DanielKirchner/bachelorarbeit/README.md

# Entwicklung einer hardwarebasierten Berechnung der Mandelbrotmenge auf einem FPGA

Dieses Repoistory enthält alle selbsterstellten Ressourcen zur gleichnamigen Bachelorarbeit.
Folgende Dateien sind enthalten:

| Pfad | Beschreibung |
| --- | --- |
|`/arbeit/`|Latex-Quelldateien der Bachelorarbeit. Ordner `/arbeit/img/` enthält alle in der Arbeit verwendeten Bilder.|
|`/präsentation/`|Latex-Quelldateien der Präsentation im Rahmen des Bachelorseminars. Ordner `/präsentation/img/` enthält alle in der Arbeit verwendeten Bilder.|
|`/scripts/`|Enthält Python3 Skripts die zur Erstellung von Darstellungen verwendet wurden.|
|`/scripts/divergenz.py`|Interaktives Skript zur Darstellung der Divergenz/Konvergenz von auswählbaren komplexzahligen Punkten.|
|`/scripts/mandelbrot-single-point.py`|Skript zur Ausgabe der Punkte `z`, die für ein bestimmtes `c` iteriert werden.|
|`/scripts/tree.py`|Turtle-Skript zum Darstellen eines fraktalen Baums. Modifizierter Code von [stackoverflow](https://stackoverflow.com/questions/39853005/drawing-a-fractal-tree-in-python-not-sure-how-to-proceed).|
|`/scripts/utils.py`|Skript mit verschiedenen Utility-Funktionen, die im Rahmen des Projekts nützlich waren.|
|`/src/`|Vivado VHDL-Projekt des entwickelten FPGA-Systems.|
|`/waveforms/`|WaveDrom Quelldateien zur Erstellung der in der Arbeit dargestellten  Wellenformen.|
