DanielKirchner/bachelorarbeit/präsentation/präsentation.pdf

D. Kirchner, Mandelbrotmenge in Hardware

## Entwicklung einer hardwarebeschleunigten Berechnung der Mandelbrotmenge auf einem FPGA

Daniel Kirchner

betreut durch: Prof. Oliver Engel Hochschule Coburg

21.05.2019

## Ubersicht ¨

Die Mandelbrotmenge

Umsetzung in Hardware

Optimierungen

Die Mandelbrotmenge

## Die Mandelbrotmenge

I nach Benoˆıt Mandelbrot, Begr¨under des Begriffs ”Fraktal” I lat. fractus: gebrochen
I selbst¨ahnliche Strukturen in Natur und Mathematik

## Fraktale in der Natur

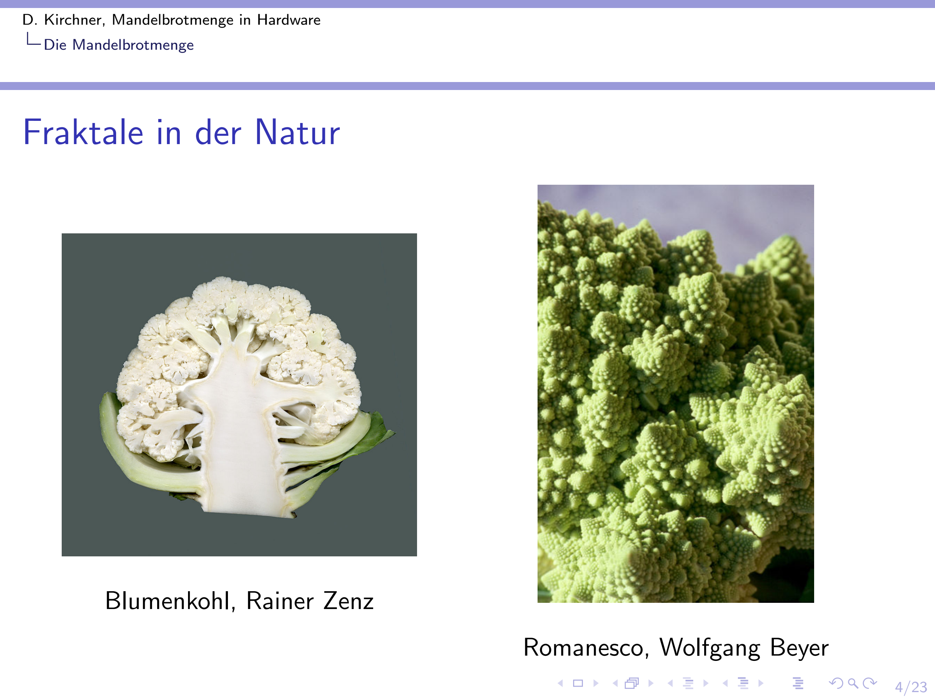
[picture p32: page 4]

Die Mandelbrotmenge

Blumenkohl, Rainer Zenz

Romanesco, Wolfgang Beyer

Die Mandelbrotmenge

Demonstration: Fraktaler Baum

Die Mandelbrotmenge

## Definition

Definiert durch iterative Formel:

z0 = 0

zn+1 = z

2
n + c

Zur Menge geh¨oren diejenigen c, f¨ur die die Folge beschr¨ankt ist.

Die Mandelbrotmenge

Demonstration: Konvergenz/Divergenz verschiedener c

Die Mandelbrotmenge

## Darstellung

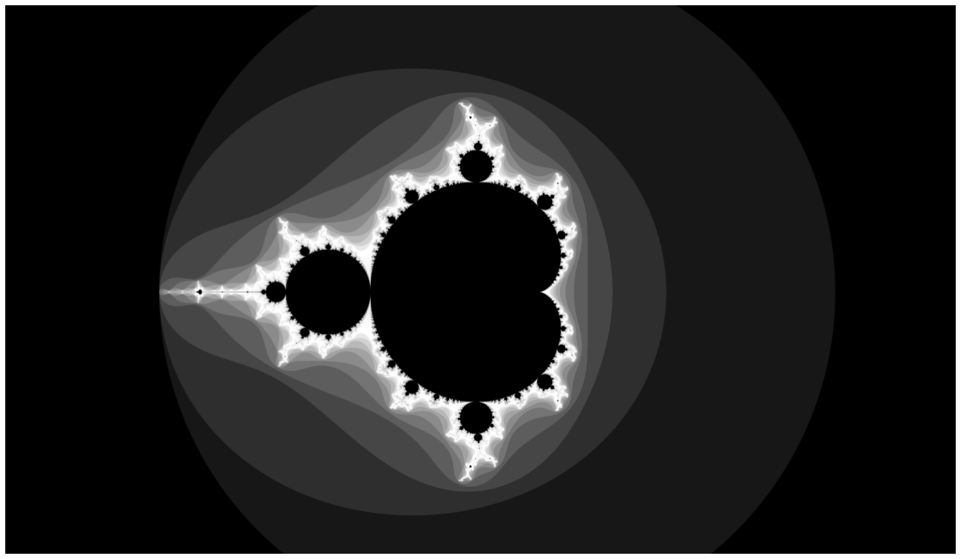
[picture p33: figure]

Umsetzung in Hardware

## Umsetzung in Hardware

I Problem: Visualisierung der Mandelbrotmenge enorm rechenintensiv
I L¨osung: Jedoch leicht parallelisierbar, ideal f¨ur Hardwareeinsatz

Umsetzung in Hardware

## Gegebene Hardware

Zybo FPGA Trainer Board
I 28.000 Logikzellen
I 240 KB Block RAM
I 80 DSPs
I Dual-Core ARM
processor
I VGA Output

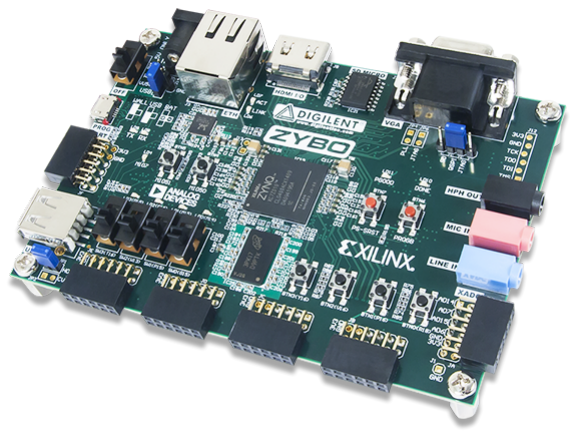
[picture p34: figure]

Zybo Board, Digilent

Umsetzung in Hardware

## Komponenten


Umsetzung in Hardware

## Mandelbrot Core

I Berechnet f¨ur gegebenes c die Anzahl an ben¨otigten Iterationen
I Ziel: eine Iteration pro Takt

Umsetzung in Hardware

## Koordinator

I Ubersetzt Pixelkoordinaten in einzelne ¨ | c Werte

I Koordiniert die Inputs der einzelnen Kerne
I Schreibt Ergebniswerte (Iterationen) in den BRAM

Umsetzung in Hardware

## VGA Modul / Block RAM

I Werte im RAM Stellen Iterationsbereich da I 240 KB Block RAM verf¨ugbar
I 800x600 Signal mit 3 Bit pro Pixel
I 8 Farben pro Pixel
I Funktionsweise: Pixel f¨ur Pixel auslesen und darstellen

Umsetzung in Hardware

## VGA Modul

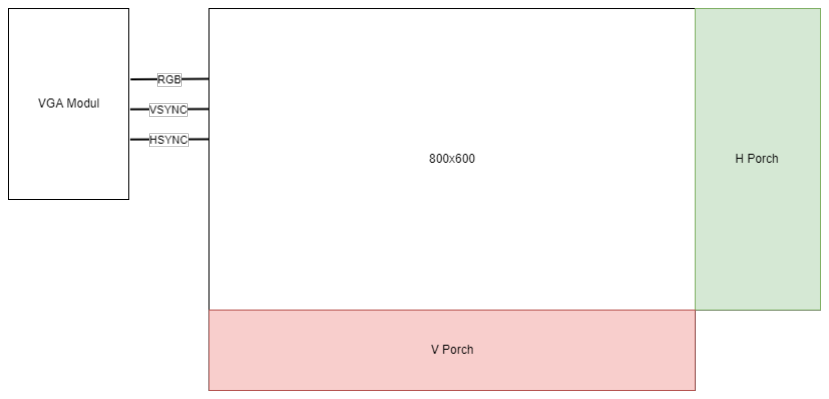
[picture p35: figure]

Umsetzung in Hardware

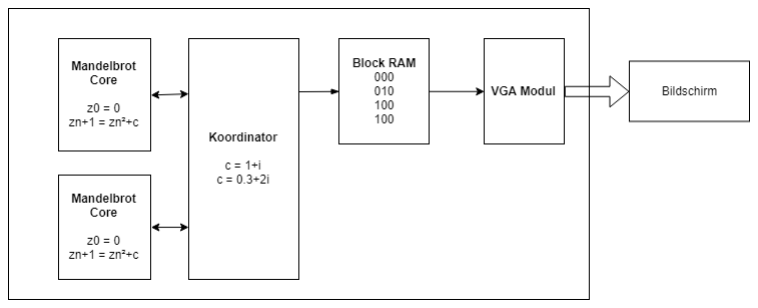
[picture p36: figure]

Optimierungen

## Algebraische Optimierungen

In jedem Schritt:
z = z

2 + c

und dann Abfrage:
abs(z) <= 2

Ziel: Minimale Zahl von Multiplikationen

Optimierungen

abs(z) <= 2

⇔

q
z

2
r + z

2
i <= 2

⇔ z

2
r + z

2
i <= 4

Optimierungen

z = z

2 + c

⇔ z = z

2
r − z

2
i + 2zr zi + c

zr = z

2
r − z

2
i + cr

zi = 2zr zi + ci

⇔ zi = zr zi + zr zi + ci

Optimierungen

z

2
r + z

2
i <= 4

zr = z

2
r − z

2
i + cr

zi = zr zi + zr zi + ci

Optimierungen

## Designtechnische Optimierungen

I VGA-Modul und Mandelbrotcores m¨ussen beide auf BRAM zugreifen → Dual Port RAM
I Mandelbrotmenge ist geschlossen: y zwischen -1.25 und 1.25, x zwischen -2 und 0,5 → Punkte außerhalb nicht in Menge I Eigener signed-Datenformat

Optimierungen

## Zahlenformat

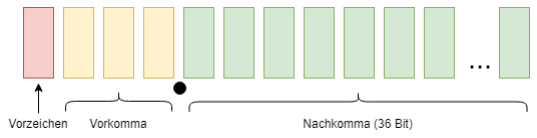
[picture p37: figure]
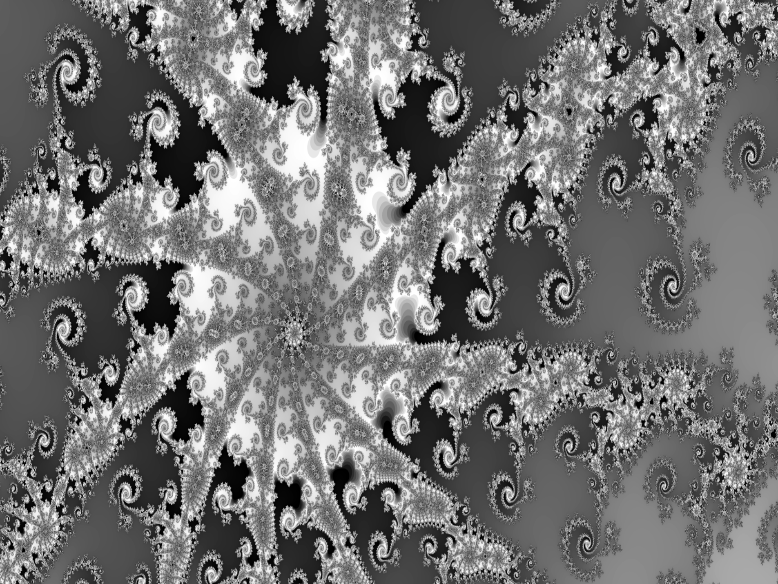
[picture p38: page 23]
