DanielKirchner/bachelorarbeit/arbeit/img/mandelbrot_1.png

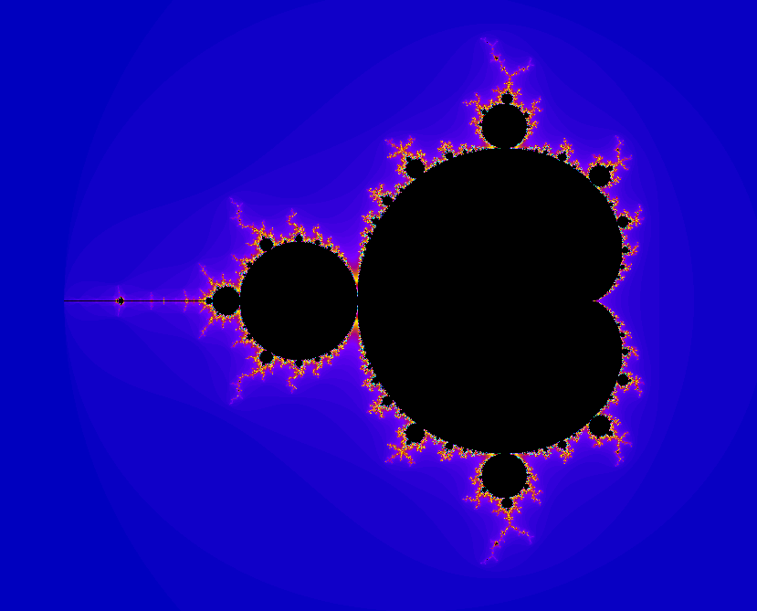
arbeit/img/mandelbrot_1.png
