DanielKirchner/bachelorarbeit/arbeit/img/mandelbrot_2.png

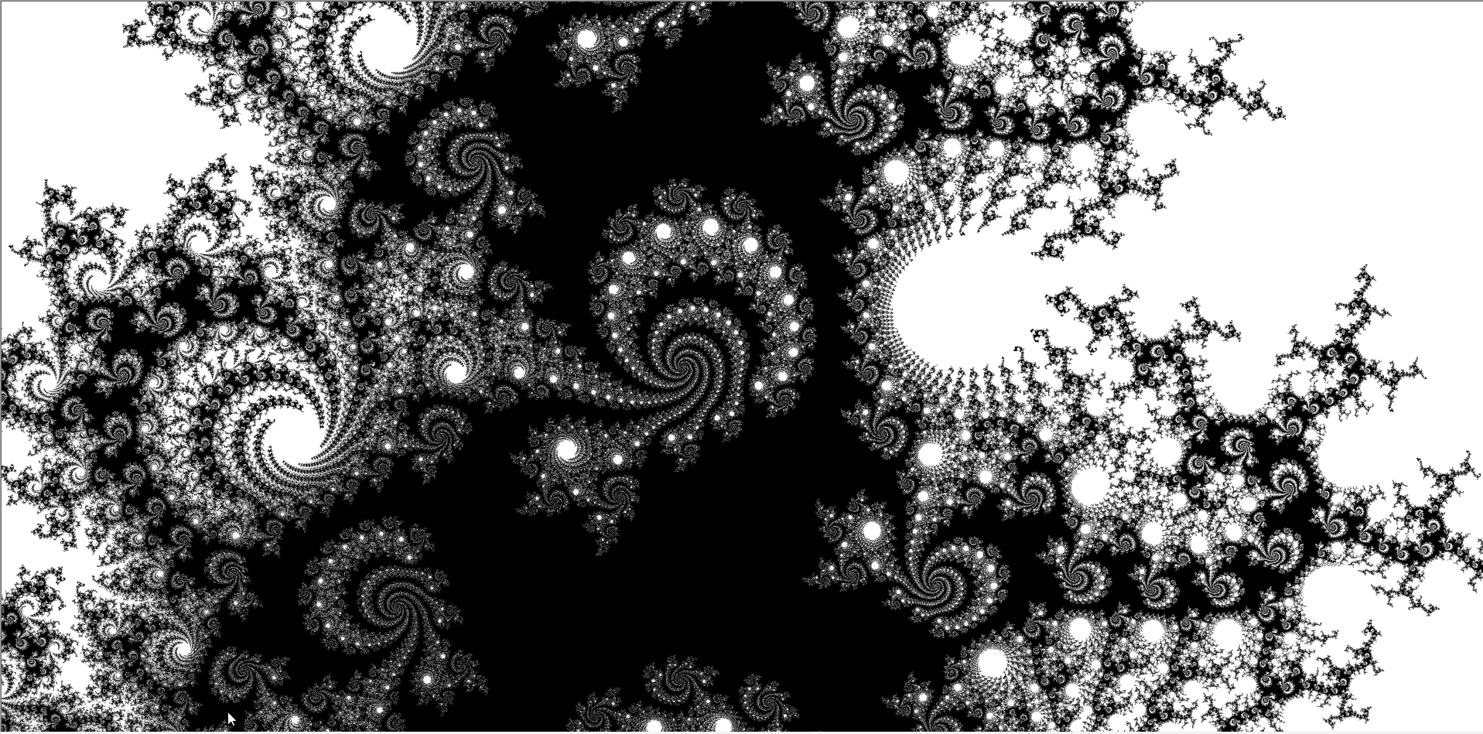
arbeit/img/mandelbrot_2.png
