DanielKirchner/bachelorarbeit/arbeit/img/realtop.png

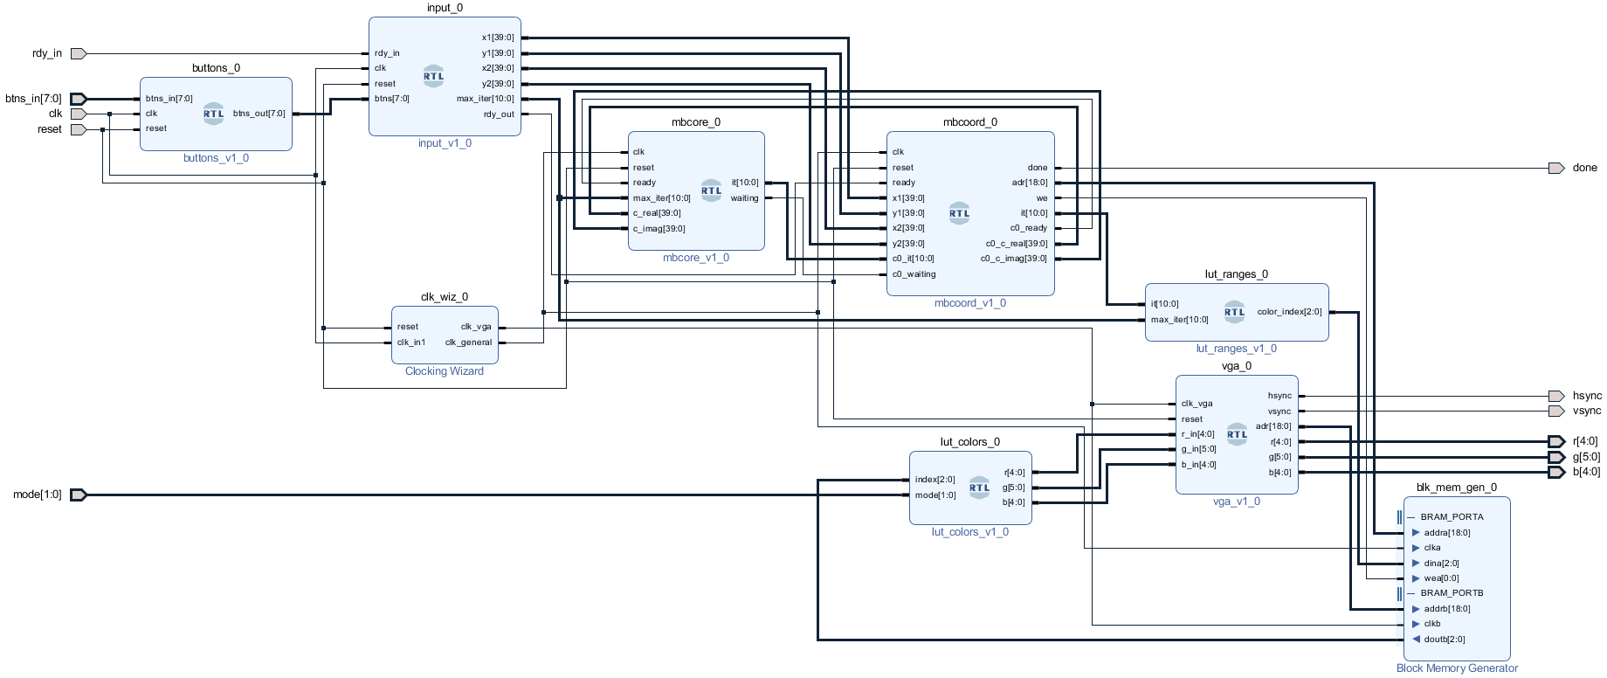
arbeit/img/realtop.png
