DanielKirchner/bachelorarbeit/src/mandel-zybo.srcs/sources_1/bd/top/ip/top_input_0_0/top_input_0_0_sim_netlist.v

// Copyright 1986-2018 Xilinx, Inc. All Rights Reserved.
// --------------------------------------------------------------------------------
// Tool Version: Vivado v.2018.3 (lin64) Build 2405991 Thu Dec  6 23:36:41 MST 2018
// Date        : Sun Jul 28 16:13:38 2019
// Host        : daniel-pc running 64-bit unknown
// Command     : write_verilog -force -mode funcsim
//               /home/daniel/prg/uni/bachelor/src/mandel-zybo.srcs/sources_1/bd/top/ip/top_input_0_0/top_input_0_0_sim_netlist.v
// Design      : top_input_0_0
// Purpose     : This verilog netlist is a functional simulation representation of the design and should not be modified
//               or synthesized. This netlist cannot be used for SDF annotated simulation.
// Device      : xc7z010clg400-1
// --------------------------------------------------------------------------------
`timescale 1 ps / 1 ps

(* CHECK_LICENSE_TYPE = "top_input_0_0,input,{}" *) (* downgradeipidentifiedwarnings = "yes" *) (* ip_definition_source = "module_ref" *) 
(* x_core_info = "input,Vivado 2018.3" *) 
(* NotValidForBitStream *)
module top_input_0_0
   (clk,
    reset,
    btns,
    x1,
    y1,
    x2,
    y2,
    max_iter,
    rdy_out);
  (* x_interface_info = "xilinx.com:signal:clock:1.0 clk CLK" *) (* x_interface_parameter = "XIL_INTERFACENAME clk, ASSOCIATED_RESET reset, FREQ_HZ 125000000, PHASE 0.000, CLK_DOMAIN top_clk, INSERT_VIP 0" *) input clk;
  (* x_interface_info = "xilinx.com:signal:reset:1.0 reset RST" *) (* x_interface_parameter = "XIL_INTERFACENAME reset, POLARITY ACTIVE_HIGH, INSERT_VIP 0" *) input reset;
  input [7:0]btns;
  output [39:0]x1;
  output [39:0]y1;
  output [39:0]x2;
  output [39:0]y2;
  output [13:0]max_iter;
  output rdy_out;

  wire \<const1> ;
  wire [7:0]btns;
  wire clk;
  wire [13:0]max_iter;
  wire reset;
  wire [39:0]x1;
  wire [39:0]x2;
  wire [39:0]y1;
  wire [39:0]y2;

  assign rdy_out = \<const1> ;
  top_input_0_0_input U0
       (.Q(y2),
        .btns(btns),
        .clk(clk),
        .max_iter(max_iter),
        .reset(reset),
        .\x1_intern_reg[39]_0 (x1),
        .\x2_intern_reg[39]_0 (x2),
        .\y1_intern_reg[39]_0 (y1));
  VCC VCC
       (.P(\<const1> ));
endmodule

(* ORIG_REF_NAME = "input" *) 
module top_input_0_0_input
   (Q,
    \y1_intern_reg[39]_0 ,
    \x2_intern_reg[39]_0 ,
    \x1_intern_reg[39]_0 ,
    max_iter,
    btns,
    clk,
    reset);
  output [39:0]Q;
  output [39:0]\y1_intern_reg[39]_0 ;
  output [39:0]\x2_intern_reg[39]_0 ;
  output [39:0]\x1_intern_reg[39]_0 ;
  output [13:0]max_iter;
  input [7:0]btns;
  input clk;
  input reset;

  wire [39:0]Q;
  wire [31:0]SHIFT_RIGHT;
  wire [7:0]btns;
  wire [7:0]btns_old;
  wire clk;
  wire i__carry__0_i_10_n_0;
  wire i__carry__0_i_10_n_1;
  wire i__carry__0_i_10_n_2;
  wire i__carry__0_i_10_n_3;
  wire i__carry__0_i_10_n_4;
  wire i__carry__0_i_10_n_5;
  wire i__carry__0_i_10_n_6;
  wire i__carry__0_i_10_n_7;
  wire i__carry__0_i_11_n_0;
  wire i__carry__0_i_12_n_0;
  wire i__carry__0_i_13_n_0;
  wire i__carry__0_i_14_n_0;
  wire i__carry__0_i_1__0_n_0;
  wire i__carry__0_i_1__1_n_0;
  wire i__carry__0_i_1__2_n_0;
  wire i__carry__0_i_1__3_n_0;
  wire i__carry__0_i_1__4_n_0;
  wire i__carry__0_i_1__5_n_0;
  wire i__carry__0_i_1__6_n_0;
  wire i__carry__0_i_1_n_0;
  wire i__carry__0_i_2__0_n_0;
  wire i__carry__0_i_2__1_n_0;
  wire i__carry__0_i_2__2_n_0;
  wire i__carry__0_i_2__3_n_0;
  wire i__carry__0_i_2__4_n_0;
  wire i__carry__0_i_2__5_n_0;
  wire i__carry__0_i_2__6_n_0;
  wire i__carry__0_i_2_n_0;
  wire i__carry__0_i_3__0_n_0;
  wire i__carry__0_i_3__1_n_0;
  wire i__carry__0_i_3__2_n_0;
  wire i__carry__0_i_3__3_n_0;
  wire i__carry__0_i_3__4_n_0;
  wire i__carry__0_i_3__5_n_0;
  wire i__carry__0_i_3__6_n_0;
  wire i__carry__0_i_3_n_0;
  wire i__carry__0_i_4__0_n_0;
  wire i__carry__0_i_4__1_n_0;
  wire i__carry__0_i_4__2_n_0;
  wire i__carry__0_i_4__3_n_0;
  wire i__carry__0_i_4__4_n_0;
  wire i__carry__0_i_4__5_n_0;
  wire i__carry__0_i_4__6_n_0;
  wire i__carry__0_i_4_n_0;
  wire i__carry__0_i_5__0_n_0;
  wire i__carry__0_i_5__1_n_0;
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
  wire \zoom_level_reg[8]_i_1_n_6 ;
  wire \zoom_level_reg[8]_i_1_n_7 ;
  wire [3:2]NLW_i__carry__7_i_10_CO_UNCONNECTED;
  wire [3:3]NLW_i__carry__7_i_10_O_UNCONNECTED;
  wire [3:1]NLW_i__carry__8_i_5_CO_UNCONNECTED;
  wire [3:2]NLW_i__carry__8_i_5_O_UNCONNECTED;
  wire [3:0]NLW_i__carry__8_i_5__0_CO_UNCONNECTED;
  wire [3:1]NLW_i__carry__8_i_5__0_O_UNCONNECTED;
  wire [3:1]NLW_i__carry__8_i_5__1_CO_UNCONNECTED;
  wire [3:2]NLW_i__carry__8_i_5__1_O_UNCONNECTED;
  wire NLW_max_iter0_CARRYCASCOUT_UNCONNECTED;
  wire NLW_max_iter0_MULTSIGNOUT_UNCONNECTED;
  wire NLW_max_iter0_OVERFLOW_UNCONNECTED;
  wire NLW_max_iter0_PATTERNBDETECT_UNCONNECTED;
  wire NLW_max_iter0_PATTERNDETECT_UNCONNECTED;
  wire NLW_max_iter0_UNDERFLOW_UNCONNECTED;
  wire [29:0]NLW_max_iter0_ACOUT_UNCONNECTED;
  wire [17:0]NLW_max_iter0_BCOUT_UNCONNECTED;
  wire [3:0]NLW_max_iter0_CARRYOUT_UNCONNECTED;
  wire [47:14]NLW_max_iter0_P_UNCONNECTED;
  wire [47:0]NLW_max_iter0_PCOUT_UNCONNECTED;
  wire [3:3]\NLW_x1_intern0_inferred__0/i__carry__8_CO_UNCONNECTED ;
  wire [3:3]\NLW_x1_intern0_inferred__1/i__carry__8_CO_UNCONNECTED ;
  wire [3:3]\NLW_x1_intern0_inferred__2/i__carry__8_CO_UNCONNECTED ;
  wire [3:0]\NLW_x1_intern1_inferred__2/i__carry_O_UNCONNECTED ;
  wire [3:0]\NLW_x1_intern1_inferred__2/i__carry__0_O_UNCONNECTED ;
  wire [3:0]\NLW_x1_intern1_inferred__2/i__carry__1_O_UNCONNECTED ;
  wire [3:0]\NLW_x1_intern1_inferred__2/i__carry__2_O_UNCONNECTED ;
  wire [3:3]NLW_x1_intern4_carry__8_CO_UNCONNECTED;
  wire [3:3]NLW_x2_intern0_carry__8_CO_UNCONNECTED;
  wire [3:3]\NLW_x2_intern0_inferred__0/i__carry__8_CO_UNCONNECTED ;
  wire [3:3]\NLW_x2_intern0_inferred__1/i__carry__8_CO_UNCONNECTED ;
  wire [3:3]NLW_y1_intern0_carry__8_CO_UNCONNECTED;
  wire [3:3]\NLW_y1_intern0_inferred__0/i__carry__8_CO_UNCONNECTED ;
  wire [3:3]NLW_y1_intern4_carry__8_CO_UNCONNECTED;
  wire [3:3]\NLW_y1_intern_reg[39]_i_2_CO_UNCONNECTED ;
  wire [3:2]NLW_y2_intern0_carry__7_i_10_CO_UNCONNECTED;
  wire [3:3]NLW_y2_intern0_carry__7_i_10_O_UNCONNECTED;
  wire [3:3]NLW_y2_intern0_carry__8_CO_UNCONNECTED;
  wire [3:0]NLW_y2_intern0_carry__8_i_5_CO_UNCONNECTED;
  wire [3:1]NLW_y2_intern0_carry__8_i_5_O_UNCONNECTED;
  wire [3:3]\NLW_y2_intern0_inferred__0/i__carry__8_CO_UNCONNECTED ;
  wire [3:3]\NLW_y2_intern_reg[39]_i_1_CO_UNCONNECTED ;
  wire [3:3]\NLW_zoom_level_reg[28]_i_1_CO_UNCONNECTED ;
  wire [3:2]\NLW_zoom_level_reg[28]_i_6_CO_UNCONNECTED ;
  wire [3:3]\NLW_zoom_level_reg[28]_i_6_O_UNCONNECTED ;
  wire [3:2]\NLW_zoom_level_reg[28]_i_7_CO_UNCONNECTED ;
  wire [3:3]\NLW_zoom_level_reg[28]_i_7_O_UNCONNECTED ;
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
