DanielKirchner/bachelorarbeit/src/mandel-zybo.srcs/sources_1/bd/top/ip/top_lut_ranges_0_0/top_lut_ranges_0_0_sim_netlist.v

// Copyright 1986-2018 Xilinx, Inc. All Rights Reserved.
// --------------------------------------------------------------------------------
// Tool Version: Vivado v.2018.3 (lin64) Build 2405991 Thu Dec  6 23:36:41 MST 2018
// Date        : Sun Jul 14 17:17:30 2019
// Host        : daniel-pc running 64-bit unknown
// Command     : write_verilog -force -mode funcsim
//               /home/daniel/prg/uni/bachelor/src/mandel-zybo.srcs/sources_1/bd/top/ip/top_lut_ranges_0_0/top_lut_ranges_0_0_sim_netlist.v
// Design      : top_lut_ranges_0_0
// Purpose     : This verilog netlist is a functional simulation representation of the design and should not be modified
//               or synthesized. This netlist cannot be used for SDF annotated simulation.
// Device      : xc7z010clg400-1
// --------------------------------------------------------------------------------
`timescale 1 ps / 1 ps

(* CHECK_LICENSE_TYPE = "top_lut_ranges_0_0,lut_ranges,{}" *) (* downgradeipidentifiedwarnings = "yes" *) (* ip_definition_source = "module_ref" *) 
(* x_core_info = "lut_ranges,Vivado 2018.3" *) 
(* NotValidForBitStream *)
module top_lut_ranges_0_0
   (it,
    max_iter,
    color_index);
  input [13:0]it;
  input [13:0]max_iter;
  output [3:0]color_index;

  wire U0_n_0;
  wire U0_n_5;
  wire U0_n_6;
  wire [3:0]color_index;
  wire color_index1__101_carry_i_18_n_0;
  wire color_index1__115_carry__0_i_11_n_0;
  wire color_index1__115_carry__0_i_12_n_0;
  wire color_index1__115_carry__0_i_13_n_0;
  wire color_index1__115_carry__0_i_14_n_0;
  wire color_index1__115_carry__0_i_15_n_0;
  wire color_index1__115_carry__1_i_11_n_0;
  wire color_index1__115_carry__1_i_12_n_0;
  wire color_index1__115_carry__1_i_13_n_0;
  wire color_index1__115_carry__1_i_14_n_0;
  wire color_index1__115_carry__1_i_15_n_0;
  wire color_index1__115_carry__1_i_16_n_0;
  wire color_index1__115_carry__1_i_17_n_0;
  wire color_index1__115_carry__1_i_18_n_0;
  wire color_index1__115_carry__2_i_6_n_0;
  wire color_index1__115_carry__2_i_7_n_0;
  wire color_index1__129_carry_i_18_n_0;
  wire color_index1__143_carry__0_i_11_n_7;
  wire color_index1__143_carry_i_18_n_0;
  wire color_index1__157_carry_i_18_n_0;
  wire color_index1__171_carry_i_18_n_0;
  wire color_index1__185_carry_i_18_n_0;
  wire color_index1__199_carry__0_i_11_n_7;
  wire color_index1__199_carry_i_18_n_0;
  wire color_index1__213_carry__0_i_24_n_3;
  wire color_index1__213_carry__0_i_25_n_0;
  wire color_index1__213_carry__0_i_26_n_0;
  wire color_index1__213_carry_i_34_n_0;
  wire color_index1__213_carry_i_34_n_1;
  wire color_index1__213_carry_i_34_n_2;
  wire color_index1__213_carry_i_34_n_3;
  wire color_index1__213_carry_i_35_n_0;
  wire color_index1__213_carry_i_35_n_1;
  wire color_index1__213_carry_i_35_n_2;
  wire color_index1__213_carry_i_35_n_3;
  wire color_index1__213_carry_i_36_n_0;
  wire color_index1__213_carry_i_36_n_1;
  wire color_index1__213_carry_i_36_n_2;
  wire color_index1__213_carry_i_36_n_3;
  wire color_index1__213_carry_i_37_n_0;
  wire color_index1__213_carry_i_38_n_0;
  wire color_index1__213_carry_i_39_n_0;
  wire color_index1__213_carry_i_40_n_0;
  wire color_index1__213_carry_i_41_n_0;
  wire color_index1__213_carry_i_42_n_0;
  wire color_index1__213_carry_i_43_n_0;
  wire color_index1__213_carry_i_44_n_0;
  wire color_index1__213_carry_i_45_n_0;
  wire color_index1__213_carry_i_46_n_0;
  wire color_index1__213_carry_i_47_n_0;
  wire color_index1__31_carry__0_i_11_n_0;
  wire color_index1__31_carry__0_i_12_n_0;
  wire color_index1__31_carry__0_i_13_n_0;
  wire color_index1__31_carry__0_i_14_n_0;
  wire color_index1__31_carry__0_i_15_n_0;
  wire color_index1__31_carry__1_i_11_n_0;
  wire color_index1__31_carry__1_i_12_n_0;
  wire color_index1__31_carry__1_i_13_n_0;
  wire color_index1__31_carry__1_i_14_n_0;
  wire color_index1__31_carry__1_i_15_n_0;
  wire color_index1__31_carry__1_i_16_n_0;
  wire color_index1__31_carry__1_i_17_n_0;
  wire color_index1__31_carry__1_i_18_n_0;
  wire color_index1__31_carry__2_i_6_n_0;
  wire color_index1__31_carry__2_i_7_n_0;
  wire color_index1__31_carry__2_i_8_n_0;
  wire color_index1__31_carry__2_i_9_n_0;
  wire color_index1__31_carry_i_17_n_0;
  wire color_index1__45_carry_i_18_n_0;
  wire color_index1__59_carry__0_i_11_n_0;
  wire color_index1__59_carry__0_i_12_n_0;
  wire color_index1__59_carry__0_i_13_n_0;
  wire color_index1__59_carry__0_i_14_n_0;
  wire color_index1__59_carry__0_i_15_n_0;
  wire color_index1__59_carry__1_i_11_n_0;
  wire color_index1__59_carry__1_i_12_n_0;
  wire color_index1__59_carry__1_i_13_n_0;
  wire color_index1__59_carry__1_i_14_n_0;
  wire color_index1__59_carry__1_i_15_n_0;
  wire color_index1__59_carry__1_i_16_n_0;
  wire color_index1__59_carry__1_i_17_n_0;
  wire color_index1__59_carry__1_i_18_n_0;
  wire color_index1__59_carry__2_i_6_n_0;
  wire color_index1__59_carry__2_i_7_n_0;
  wire color_index1__59_carry__2_i_8_n_0;
  wire color_index1__59_carry_i_17_n_0;
  wire color_index1__73_carry_i_18_n_0;
  wire color_index1__87_carry_i_18_n_0;
  wire [13:0]it;
  wire [13:0]max_iter;
  wire [13:1]multOp;
  wire [3:0]NLW_color_index1__143_carry__0_i_11_CO_UNCONNECTED;
  wire [3:1]NLW_color_index1__143_carry__0_i_11_O_UNCONNECTED;
  wire [3:0]NLW_color_index1__199_carry__0_i_11_CO_UNCONNECTED;
  wire [3:1]NLW_color_index1__199_carry__0_i_11_O_UNCONNECTED;
  wire [3:1]NLW_color_index1__213_carry__0_i_24_CO_UNCONNECTED;
  wire [3:2]NLW_color_index1__213_carry__0_i_24_O_UNCONNECTED;
  wire [0:0]NLW_color_index1__213_carry_i_36_O_UNCONNECTED;

  top_lut_ranges_0_0_lut_ranges U0
       (.CO(U0_n_5),
        .O(color_index1__143_carry__0_i_11_n_7),
        .S(color_index1__31_carry_i_17_n_0),
        .color_index(color_index),
        .color_index1__101_carry_i_8_0(color_index1__101_carry_i_18_n_0),
        .color_index1__115_carry__0_i_1_0({color_index1__115_carry__0_i_11_n_0,color_index1__115_carry__0_i_12_n_0,color_index1__115_carry__0_i_13_n_0,color_index1__115_carry__0_i_14_n_0}),
        .color_index1__115_carry__0_i_7_0(color_index1__115_carry__0_i_15_n_0),
        .color_index1__115_carry__1_i_1_0({color_index1__115_carry__1_i_11_n_0,color_index1__115_carry__1_i_12_n_0,color_index1__115_carry__1_i_13_n_0,color_index1__115_carry__1_i_14_n_0}),
        .color_index1__115_carry__1_i_3_0({color_index1__115_carry__1_i_15_n_0,color_index1__115_carry__1_i_16_n_0,color_index1__115_carry__1_i_17_n_0,color_index1__115_carry__1_i_18_n_0}),
        .color_index1__115_carry__2_i_1_0({color_index1__115_carry__2_i_6_n_0,color_index1__115_carry__2_i_7_n_0}),
        .color_index1__129_carry_i_4_0(color_index1__129_carry_i_18_n_0),
        .color_index1__143_carry_i_7_0(color_index1__143_carry_i_18_n_0),
        .color_index1__157_carry_i_8_0(color_index1__157_carry_i_18_n_0),
        .color_index1__171_carry_i_7_0(color_index1__171_carry_i_18_n_0),
        .color_index1__185_carry_i_8_0(color_index1__73_carry_i_18_n_0),
        .color_index1__185_carry_i_8_1(color_index1__185_carry_i_18_n_0),
        .color_index1__199_carry__0_i_21_0(U0_n_6),
        .color_index1__199_carry__2_i_2_0(color_index1__199_carry__0_i_11_n_7),
        .color_index1__199_carry_i_7_0(color_index1__199_carry_i_18_n_0),
        .color_index1__213_carry__0_i_11_0(multOp),
        .color_index1__31_carry__0_i_6_0({color_index1__31_carry__0_i_11_n_0,color_index1__31_carry__0_i_12_n_0,color_index1__31_carry__0_i_13_n_0,color_index1__31_carry__0_i_14_n_0}),
        .color_index1__31_carry__0_i_8_0(color_index1__31_carry__0_i_15_n_0),
        .color_index1__31_carry__1_i_2_0({color_index1__31_carry__1_i_11_n_0,color_index1__31_carry__1_i_12_n_0,color_index1__31_carry__1_i_13_n_0,color_index1__31_carry__1_i_14_n_0}),
        .color_index1__31_carry__1_i_4_0({color_index1__31_carry__1_i_15_n_0,color_index1__31_carry__1_i_16_n_0,color_index1__31_carry__1_i_17_n_0,color_index1__31_carry__1_i_18_n_0}),
        .color_index1__31_carry__2_i_2_0({color_index1__31_carry__2_i_6_n_0,color_index1__31_carry__2_i_7_n_0,color_index1__31_carry__2_i_8_n_0,color_index1__31_carry__2_i_9_n_0}),
        .color_index1__45_carry_i_8_0(color_index1__45_carry_i_18_n_0),
        .color_index1__59_carry__0_i_6_0({color_index1__59_carry__0_i_11_n_0,color_index1__59_carry__0_i_12_n_0,color_index1__59_carry__0_i_13_n_0,color_index1__59_carry__0_i_14_n_0}),
        .color_index1__59_carry__0_i_8_0(color_index1__59_carry__0_i_15_n_0),
        .color_index1__59_carry__1_i_2_0({color_index1__59_carry__1_i_11_n_0,color_index1__59_carry__1_i_12_n_0,color_index1__59_carry__1_i_13_n_0,color_index1__59_carry__1_i_14_n_0}),
        .color_index1__59_carry__1_i_4_0({color_index1__59_carry__1_i_15_n_0,color_index1__59_carry__1_i_16_n_0,color_index1__59_carry__1_i_17_n_0,color_index1__59_carry__1_i_18_n_0}),
        .color_index1__59_carry__2_i_2_0({color_index1__59_carry__2_i_6_n_0,color_index1__59_carry__2_i_7_n_0,color_index1__59_carry__2_i_8_n_0}),
        .color_index1__59_carry_i_8_0(color_index1__59_carry_i_17_n_0),
        .color_index1__87_carry_i_7_0(color_index1__87_carry_i_18_n_0),
        .it(it),
        .max_iter(max_iter),
        .max_iter_9_sp_1(U0_n_0));
  LUT2 #(
    .INIT(4'h6)) 
    color_index1__101_carry_i_18
       (.I0(max_iter[0]),
        .I1(max_iter[4]),
        .O(color_index1__101_carry_i_18_n_0));
  LUT5 #(
    .INIT(32'hFFFFFFFE)) 
    color_index1__115_carry__0_i_11
       (.I0(max_iter[13]),
        .I1(max_iter[11]),
        .I2(U0_n_0),
        .I3(max_iter[10]),
        .I4(max_iter[12]),
        .O(color_index1__115_carry__0_i_11_n_0));
  LUT5 #(
    .INIT(32'hFFFFFFFE)) 
    color_index1__115_carry__0_i_12
       (.I0(max_iter[13]),
        .I1(max_iter[11]),
        .I2(U0_n_0),
        .I3(max_iter[10]),
        .I4(max_iter[12]),
        .O(color_index1__115_carry__0_i_12_n_0));
  LUT5 #(
    .INIT(32'hFFFFFFFE)) 
    color_index1__115_carry__0_i_13
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
    color_index1__185_carry_i_18
       (.I0(max_iter[0]),
        .I1(max_iter[4]),
        .O(color_index1__185_carry_i_18_n_0));
  CARRY4 color_index1__199_carry__0_i_11
       (.CI(U0_n_6),
        .CO(NLW_color_index1__199_carry__0_i_11_CO_UNCONNECTED[3:0]),
        .CYINIT(1'b0),
        .DI({1'b0,1'b0,1'b0,1'b0}),
        .O({NLW_color_index1__199_carry__0_i_11_O_UNCONNECTED[3:1],color_index1__199_carry__0_i_11_n_7}),
        .S({1'b0,1'b0,1'b0,1'b1}));
  LUT2 #(
    .INIT(4'h6)) 
    color_index1__199_carry_i_18
       (.I0(max_iter[1]),
        .I1(max_iter[4]),
        .O(color_index1__199_carry_i_18_n_0));
  CARRY4 color_index1__213_carry__0_i_24
       (.CI(color_index1__213_carry_i_34_n_0),
        .CO({NLW_color_index1__213_carry__0_i_24_CO_UNCONNECTED[3:1],color_index1__213_carry__0_i_24_n_3}),
        .CYINIT(1'b0),
        .DI({1'b0,1'b0,1'b0,max_iter[12]}),
        .O({NLW_color_index1__213_carry__0_i_24_O_UNCONNECTED[3:2],multOp[13:12]}),
        .S({1'b0,1'b0,color_index1__213_carry__0_i_25_n_0,color_index1__213_carry__0_i_26_n_0}));
  LUT1 #(
    .INIT(2'h1)) 
    color_index1__213_carry__0_i_25
       (.I0(max_iter[13]),
        .O(color_index1__213_carry__0_i_25_n_0));
  LUT1 #(
    .INIT(2'h1)) 
    color_index1__213_carry__0_i_26
       (.I0(max_iter[12]),
        .O(color_index1__213_carry__0_i_26_n_0));
  CARRY4 color_index1__213_carry_i_34
       (.CI(color_index1__213_carry_i_35_n_0),
        .CO({color_index1__213_carry_i_34_n_0,color_index1__213_carry_i_34_n_1,color_index1__213_carry_i_34_n_2,color_index1__213_carry_i_34_n_3}),
        .CYINIT(1'b0),
        .DI(max_iter[11:8]),
        .O(multOp[11:8]),
        .S({color_index1__213_carry_i_37_n_0,color_index1__213_carry_i_38_n_0,color_index1__213_carry_i_39_n_0,color_index1__213_carry_i_40_n_0}));
  CARRY4 color_index1__213_carry_i_35
       (.CI(color_index1__213_carry_i_36_n_0),
        .CO({color_index1__213_carry_i_35_n_0,color_index1__213_carry_i_35_n_1,color_index1__213_carry_i_35_n_2,color_index1__213_carry_i_35_n_3}),
        .CYINIT(1'b0),
        .DI(max_iter[7:4]),
        .O(multOp[7:4]),
        .S({color_index1__213_carry_i_41_n_0,color_index1__213_carry_i_42_n_0,color_index1__213_carry_i_43_n_0,color_index1__213_carry_i_44_n_0}));
  CARRY4 color_index1__213_carry_i_36
       (.CI(1'b0),
        .CO({color_index1__213_carry_i_36_n_0,color_index1__213_carry_i_36_n_1,color_index1__213_carry_i_36_n_2,color_index1__213_carry_i_36_n_3}),
        .CYINIT(1'b0),
        .DI({1'b0,1'b0,1'b0,1'b1}),
        .O({multOp[3:1],NLW_color_index1__213_carry_i_36_O_UNCONNECTED[0]}),
        .S({color_index1__213_carry_i_45_n_0,color_index1__213_carry_i_46_n_0,color_index1__213_carry_i_47_n_0,max_iter[4]}));
  LUT1 #(
    .INIT(2'h1)) 
    color_index1__213_carry_i_37
       (.I0(max_iter[11]),
        .O(color_index1__213_carry_i_37_n_0));
  LUT1 #(
    .INIT(2'h1)) 
    color_index1__213_carry_i_38
       (.I0(max_iter[10]),
        .O(color_index1__213_carry_i_38_n_0));
  LUT2 #(
    .INIT(4'h9)) 
    color_index1__213_carry_i_39
       (.I0(max_iter[9]),
        .I1(max_iter[13]),
        .O(color_index1__213_carry_i_39_n_0));
  LUT2 #(
    .INIT(4'h9)) 
    color_index1__213_carry_i_40
       (.I0(max_iter[8]),
        .I1(max_iter[12]),
        .O(color_index1__213_carry_i_40_n_0));
  LUT2 #(
    .INIT(4'h9)) 
    color_index1__213_carry_i_41
       (.I0(max_iter[7]),
        .I1(max_iter[11]),
        .O(color_index1__213_carry_i_41_n_0));
  LUT2 #(
    .INIT(4'h9)) 
    color_index1__213_carry_i_42
       (.I0(max_iter[6]),
        .I1(max_iter[10]),
        .O(color_index1__213_carry_i_42_n_0));
  LUT2 #(
    .INIT(4'h9)) 
    color_index1__213_carry_i_43
       (.I0(max_iter[5]),
        .I1(max_iter[9]),
        .O(color_index1__213_carry_i_43_n_0));
  LUT2 #(
    .INIT(4'h9)) 
    color_index1__213_carry_i_44
       (.I0(max_iter[4]),
        .I1(max_iter[8]),
        .O(color_index1__213_carry_i_44_n_0));
  LUT1 #(
    .INIT(2'h1)) 
    color_index1__213_carry_i_45
       (.I0(max_iter[7]),
        .O(color_index1__213_carry_i_45_n_0));
  LUT1 #(
    .INIT(2'h1)) 
    color_index1__213_carry_i_46
       (.I0(max_iter[6]),
        .O(color_index1__213_carry_i_46_n_0));
  LUT1 #(
    .INIT(2'h1)) 
    color_index1__213_carry_i_47
       (.I0(max_iter[5]),
        .O(color_index1__213_carry_i_47_n_0));
  LUT5 #(
    .INIT(32'hFFFFFFFE)) 
    color_index1__31_carry__0_i_11
       (.I0(max_iter[13]),
        .I1(max_iter[11]),
        .I2(U0_n_0),
        .I3(max_iter[10]),
        .I4(max_iter[12]),
        .O(color_index1__31_carry__0_i_11_n_0));
  LUT5 #(
    .INIT(32'hFFFFFFFE)) 
    color_index1__31_carry__0_i_12
       (.I0(max_iter[13]),
        .I1(max_iter[11]),
        .I2(U0_n_0),
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
       (.I0(max_iter[13]),
        .I1(max_iter[11]),
        .I2(U0_n_0),
        .I3(max_iter[10]),
        .I4(max_iter[12]),
        .O(color_index1__59_carry__1_i_18_n_0));
  LUT5 #(
    .INIT(32'hFFFFFFFE)) 
    color_index1__59_carry__2_i_6
       (.I0(max_iter[13]),
        .I1(max_iter[11]),
        .I2(U0_n_0),
        .I3(max_iter[10]),
        .I4(max_iter[12]),
        .O(color_index1__59_carry__2_i_6_n_0));
  LUT5 #(
    .INIT(32'hFFFFFFFE)) 
    color_index1__59_carry__2_i_7
       (.I0(max_iter[13]),
        .I1(max_iter[11]),
        .I2(U0_n_0),
        .I3(max_iter[10]),
        .I4(max_iter[12]),
        .O(color_index1__59_carry__2_i_7_n_0));
  LUT5 #(
    .INIT(32'hFFFFFFFE)) 
    color_index1__59_carry__2_i_8
       (.I0(max_iter[13]),
        .I1(max_iter[11]),
        .I2(U0_n_0),
        .I3(max_iter[10]),
        .I4(max_iter[12]),
        .O(color_index1__59_carry__2_i_8_n_0));
  LUT2 #(
    .INIT(4'h6)) 
    color_index1__59_carry_i_17
       (.I0(max_iter[2]),
        .I1(max_iter[4]),
        .O(color_index1__59_carry_i_17_n_0));
  LUT2 #(
    .INIT(4'h6)) 
    color_index1__73_carry_i_18
       (.I0(max_iter[0]),
        .I1(max_iter[4]),
        .O(color_index1__73_carry_i_18_n_0));
  LUT2 #(
    .INIT(4'h6)) 
    color_index1__87_carry_i_18
       (.I0(max_iter[1]),
        .I1(max_iter[4]),
        .O(color_index1__87_carry_i_18_n_0));
endmodule

(* ORIG_REF_NAME = "lut_ranges" *) 
module top_lut_ranges_0_0_lut_ranges
   (max_iter_9_sp_1,
    color_index,
    CO,
    color_index1__199_carry__0_i_21_0,
    max_iter,
    it,
    color_index1__213_carry__0_i_11_0,
    S,
    color_index1__31_carry__0_i_8_0,
    color_index1__31_carry__0_i_6_0,
    color_index1__31_carry__1_i_4_0,
    color_index1__31_carry__1_i_2_0,
    color_index1__31_carry__2_i_2_0,
    color_index1__45_carry_i_8_0,
    color_index1__59_carry_i_8_0,
    color_index1__59_carry__0_i_8_0,
    color_index1__59_carry__0_i_6_0,
    color_index1__59_carry__1_i_4_0,
    color_index1__59_carry__1_i_2_0,
    color_index1__59_carry__2_i_2_0,
    color_index1__185_carry_i_8_0,
    color_index1__87_carry_i_7_0,
    color_index1__101_carry_i_8_0,
    color_index1__115_carry__0_i_7_0,
    color_index1__115_carry__0_i_1_0,
    color_index1__115_carry__1_i_3_0,
    color_index1__115_carry__1_i_1_0,
    color_index1__115_carry__2_i_1_0,
    color_index1__129_carry_i_4_0,
    color_index1__143_carry_i_7_0,
    O,
    color_index1__157_carry_i_8_0,
    color_index1__171_carry_i_7_0,
    color_index1__185_carry_i_8_1,
    color_index1__199_carry_i_7_0,
    color_index1__199_carry__2_i_2_0);
  output max_iter_9_sp_1;
  output [3:0]color_index;
  output [0:0]CO;
  output [0:0]color_index1__199_carry__0_i_21_0;
  input [13:0]max_iter;
  input [13:0]it;
  input [12:0]color_index1__213_carry__0_i_11_0;
  input [0:0]S;
  input [0:0]color_index1__31_carry__0_i_8_0;
  input [3:0]color_index1__31_carry__0_i_6_0;
  input [3:0]color_index1__31_carry__1_i_4_0;
  input [3:0]color_index1__31_carry__1_i_2_0;
  input [3:0]color_index1__31_carry__2_i_2_0;
  input [0:0]color_index1__45_carry_i_8_0;
  input [0:0]color_index1__59_carry_i_8_0;
  input [0:0]color_index1__59_carry__0_i_8_0;
  input [3:0]color_index1__59_carry__0_i_6_0;
  input [3:0]color_index1__59_carry__1_i_4_0;
  input [3:0]color_index1__59_carry__1_i_2_0;
  input [2:0]color_index1__59_carry__2_i_2_0;
  input [0:0]color_index1__185_carry_i_8_0;
  input [0:0]color_index1__87_carry_i_7_0;
  input [0:0]color_index1__101_carry_i_8_0;
  input [0:0]color_index1__115_carry__0_i_7_0;
  input [3:0]color_index1__115_carry__0_i_1_0;
  input [3:0]color_index1__115_carry__1_i_3_0;
  input [3:0]color_index1__115_carry__1_i_1_0;
  input [1:0]color_index1__115_carry__2_i_1_0;
  input [0:0]color_index1__129_carry_i_4_0;
  input [0:0]color_index1__143_carry_i_7_0;
  input [0:0]O;
  input [0:0]color_index1__157_carry_i_8_0;
  input [0:0]color_index1__171_carry_i_7_0;
  input [0:0]color_index1__185_carry_i_8_1;
  input [0:0]color_index1__199_carry_i_7_0;
  input [0:0]color_index1__199_carry__2_i_2_0;

  wire [0:0]CO;
  wire [0:0]O;
  wire [0:0]S;
  wire [3:0]color_index;
  wire color_index0_carry__0_i_1_n_0;
  wire color_index0_carry__0_i_2_n_0;
  wire color_index0_carry__0_i_3_n_0;
  wire color_index0_carry__0_i_4_n_0;
  wire color_index0_carry__0_i_5_n_0;
  wire color_index0_carry__0_i_6_n_0;
  wire color_index0_carry__0_i_7_n_0;
  wire color_index0_carry__0_n_0;
  wire color_index0_carry__0_n_1;
  wire color_index0_carry__0_n_2;
  wire color_index0_carry__0_n_3;
  wire color_index0_carry__1_i_1_n_0;
  wire color_index0_carry__1_i_2_n_0;
  wire color_index0_carry__1_i_3_n_0;
  wire color_index0_carry__1_i_4_n_0;
  wire color_index0_carry__1_n_0;
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
  wire color_index1__87_carry_i_29_n_7;
  wire color_index1__87_carry_i_2_n_0;
  wire color_index1__87_carry_i_30_n_0;
  wire color_index1__87_carry_i_30_n_1;
  wire color_index1__87_carry_i_30_n_2;
  wire color_index1__87_carry_i_30_n_3;
  wire color_index1__87_carry_i_30_n_4;
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
