DanielKirchner/bachelorarbeit/src/mandel-zybo.srcs/sources_1/bd/top/ip/top_mbcore_0_0/top_mbcore_0_0_sim_netlist.v

// Copyright 1986-2018 Xilinx, Inc. All Rights Reserved.
// --------------------------------------------------------------------------------
// Tool Version: Vivado v.2018.3 (lin64) Build 2405991 Thu Dec  6 23:36:41 MST 2018
// Date        : Wed Jul  3 17:57:37 2019
// Host        : daniel-pc running 64-bit unknown
// Command     : write_verilog -force -mode funcsim
//               /home/daniel/prg/uni/bachelor/src/mandel-zybo.srcs/sources_1/bd/top/ip/top_mbcore_0_0/top_mbcore_0_0_sim_netlist.v
// Design      : top_mbcore_0_0
// Purpose     : This verilog netlist is a functional simulation representation of the design and should not be modified
//               or synthesized. This netlist cannot be used for SDF annotated simulation.
// Device      : xc7z010clg400-1
// --------------------------------------------------------------------------------
`timescale 1 ps / 1 ps

(* CHECK_LICENSE_TYPE = "top_mbcore_0_0,mbcore,{}" *) (* downgradeipidentifiedwarnings = "yes" *) (* ip_definition_source = "module_ref" *) 
(* x_core_info = "mbcore,Vivado 2018.3" *) 
(* NotValidForBitStream *)
module top_mbcore_0_0
   (clk,
    reset,
    ready,
    max_iter,
    c_real,
    c_imag,
    it,
    waiting);
  (* x_interface_info = "xilinx.com:signal:clock:1.0 clk CLK" *) (* x_interface_parameter = "XIL_INTERFACENAME clk, ASSOCIATED_RESET reset, FREQ_HZ 50000000, PHASE 0.0, CLK_DOMAIN /clk_wiz_0_clk_out1, INSERT_VIP 0" *) input clk;
  (* x_interface_info = "xilinx.com:signal:reset:1.0 reset RST" *) (* x_interface_parameter = "XIL_INTERFACENAME reset, POLARITY ACTIVE_HIGH, INSERT_VIP 0" *) input reset;
  input ready;
  input [13:0]max_iter;
  input [39:0]c_real;
  input [39:0]c_imag;
  output [13:0]it;
  output waiting;

  wire [39:0]c_imag;
  wire [39:0]c_real;
  wire clk;
  wire [13:0]it;
  wire [13:0]max_iter;
  wire ready;
  wire reset;
  wire waiting;

  top_mbcore_0_0_mbcore U0
       (.c_imag(c_imag),
        .c_real(c_real),
        .clk(clk),
        .it(it),
        .max_iter(max_iter),
        .ready(ready),
        .reset(reset),
        .waiting(waiting));
endmodule

(* ORIG_REF_NAME = "mbcore" *) 
module top_mbcore_0_0_mbcore
   (it,
    waiting,
    ready,
    max_iter,
    reset,
    clk,
    c_imag,
    c_real);
  output [13:0]it;
  output waiting;
  input ready;
  input [13:0]max_iter;
  input reset;
  input clk;
  input [39:0]c_imag;
  input [39:0]c_real;

  wire [39:0]c_imag;
  wire [39:0]c_real;
  wire clk;
  wire [39:0]fixlen;
  wire [39:0]fixlen0_in;
  wire input__0_i_18_n_0;
  wire input__0_n_100;
  wire input__0_n_101;
  wire input__0_n_102;
  wire input__0_n_103;
  wire input__0_n_104;
  wire input__0_n_105;
  wire input__0_n_106;
  wire input__0_n_107;
  wire input__0_n_108;
  wire input__0_n_109;
  wire input__0_n_110;
  wire input__0_n_111;
  wire input__0_n_112;
  wire input__0_n_113;
  wire input__0_n_114;
  wire input__0_n_115;
  wire input__0_n_116;
  wire input__0_n_117;
  wire input__0_n_118;
  wire input__0_n_119;
  wire input__0_n_120;
  wire input__0_n_121;
  wire input__0_n_122;
  wire input__0_n_123;
  wire input__0_n_124;
  wire input__0_n_125;
  wire input__0_n_126;
  wire input__0_n_127;
  wire input__0_n_128;
  wire input__0_n_129;
  wire input__0_n_130;
  wire input__0_n_131;
  wire input__0_n_132;
  wire input__0_n_133;
  wire input__0_n_134;
  wire input__0_n_135;
  wire input__0_n_136;
  wire input__0_n_137;
  wire input__0_n_138;
  wire input__0_n_139;
  wire input__0_n_140;
  wire input__0_n_141;
  wire input__0_n_142;
  wire input__0_n_143;
  wire input__0_n_144;
  wire input__0_n_145;
  wire input__0_n_146;
  wire input__0_n_147;
  wire input__0_n_148;
  wire input__0_n_149;
  wire input__0_n_150;
  wire input__0_n_151;
  wire input__0_n_152;
  wire input__0_n_153;
  wire input__0_n_58;
  wire input__0_n_59;
  wire input__0_n_60;
  wire input__0_n_61;
  wire input__0_n_62;
  wire input__0_n_63;
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
  wire NLW_input__9_PATTERNDETECT_UNCONNECTED;
  wire NLW_input__9_UNDERFLOW_UNCONNECTED;
  wire [29:0]NLW_input__9_ACOUT_UNCONNECTED;
  wire [17:0]NLW_input__9_BCOUT_UNCONNECTED;
  wire [3:0]NLW_input__9_CARRYOUT_UNCONNECTED;
  wire [47:0]NLW_input__9_PCOUT_UNCONNECTED;
  wire [3:1]\NLW_iter_reg[13]_i_2_CO_UNCONNECTED ;
  wire [3:2]\NLW_iter_reg[13]_i_2_O_UNCONNECTED ;
  wire [3:0]NLW_minusOp_carry__2_CO_UNCONNECTED;
  wire [3:1]NLW_minusOp_carry__2_O_UNCONNECTED;
  wire [3:0]NLW_waiting1__4_carry_O_UNCONNECTED;
  wire [3:0]NLW_waiting1__4_carry__0_O_UNCONNECTED;
  wire [3:0]NLW_waiting1__4_carry__1_O_UNCONNECTED;
  wire [3:0]NLW_waiting1__4_carry__2_O_UNCONNECTED;
  wire [3:0]NLW_waiting1__4_carry__3_O_UNCONNECTED;
  wire [3:0]NLW_waiting1_carry_O_UNCONNECTED;
  wire [3:1]NLW_waiting1_carry__0_CO_UNCONNECTED;
  wire [3:0]NLW_waiting1_carry__0_O_UNCONNECTED;
  wire [3:3]NLW_waiting2_carry__8_CO_UNCONNECTED;
  wire [3:3]NLW_zi0_carry__8_CO_UNCONNECTED;
  wire [3:3]NLW_zr0_carry__8_CO_UNCONNECTED;
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
