DanielKirchner/bachelorarbeit/src/mandel-zybo.srcs/sources_1/bd/top/ip/top_mbcore_0_0/top_mbcore_0_0_sim_netlist.vhdl

-- Copyright 1986-2018 Xilinx, Inc. All Rights Reserved.
-- --------------------------------------------------------------------------------
-- Tool Version: Vivado v.2018.3 (lin64) Build 2405991 Thu Dec  6 23:36:41 MST 2018
-- Date        : Wed Jul  3 17:57:37 2019
-- Host        : daniel-pc running 64-bit unknown
-- Command     : write_vhdl -force -mode funcsim
--               /home/daniel/prg/uni/bachelor/src/mandel-zybo.srcs/sources_1/bd/top/ip/top_mbcore_0_0/top_mbcore_0_0_sim_netlist.vhdl
-- Design      : top_mbcore_0_0
-- Purpose     : This VHDL netlist is a functional simulation representation of the design and should not be modified or
--               synthesized. This netlist cannot be used for SDF annotated simulation.
-- Device      : xc7z010clg400-1
-- --------------------------------------------------------------------------------
library IEEE;
use IEEE.STD_LOGIC_1164.ALL;
library UNISIM;
use UNISIM.VCOMPONENTS.ALL;
entity top_mbcore_0_0_mbcore is
  port (
    it : out STD_LOGIC_VECTOR ( 13 downto 0 );
    waiting : out STD_LOGIC;
    ready : in STD_LOGIC;
    max_iter : in STD_LOGIC_VECTOR ( 13 downto 0 );
    reset : in STD_LOGIC;
    clk : in STD_LOGIC;
    c_imag : in STD_LOGIC_VECTOR ( 39 downto 0 );
    c_real : in STD_LOGIC_VECTOR ( 39 downto 0 )
  );
  attribute ORIG_REF_NAME : string;
  attribute ORIG_REF_NAME of top_mbcore_0_0_mbcore : entity is "mbcore";
end top_mbcore_0_0_mbcore;

architecture STRUCTURE of top_mbcore_0_0_mbcore is
  signal fixlen : STD_LOGIC_VECTOR ( 39 downto 0 );
  signal fixlen0_in : STD_LOGIC_VECTOR ( 39 downto 0 );
  signal \input__0_i_18_n_0\ : STD_LOGIC;
  signal \input__0_n_100\ : STD_LOGIC;
  signal \input__0_n_101\ : STD_LOGIC;
  signal \input__0_n_102\ : STD_LOGIC;
  signal \input__0_n_103\ : STD_LOGIC;
  signal \input__0_n_104\ : STD_LOGIC;
  signal \input__0_n_105\ : STD_LOGIC;
  signal \input__0_n_106\ : STD_LOGIC;
  signal \input__0_n_107\ : STD_LOGIC;
  signal \input__0_n_108\ : STD_LOGIC;
  signal \input__0_n_109\ : STD_LOGIC;
  signal \input__0_n_110\ : STD_LOGIC;
  signal \input__0_n_111\ : STD_LOGIC;
  signal \input__0_n_112\ : STD_LOGIC;
  signal \input__0_n_113\ : STD_LOGIC;
  signal \input__0_n_114\ : STD_LOGIC;
  signal \input__0_n_115\ : STD_LOGIC;
  signal \input__0_n_116\ : STD_LOGIC;
  signal \input__0_n_117\ : STD_LOGIC;
  signal \input__0_n_118\ : STD_LOGIC;
  signal \input__0_n_119\ : STD_LOGIC;
  signal \input__0_n_120\ : STD_LOGIC;
  signal \input__0_n_121\ : STD_LOGIC;
  signal \input__0_n_122\ : STD_LOGIC;
  signal \input__0_n_123\ : STD_LOGIC;
  signal \input__0_n_124\ : STD_LOGIC;
  signal \input__0_n_125\ : STD_LOGIC;
  signal \input__0_n_126\ : STD_LOGIC;
  signal \input__0_n_127\ : STD_LOGIC;
  signal \input__0_n_128\ : STD_LOGIC;
  signal \input__0_n_129\ : STD_LOGIC;
  signal \input__0_n_130\ : STD_LOGIC;
  signal \input__0_n_131\ : STD_LOGIC;
  signal \input__0_n_132\ : STD_LOGIC;
  signal \input__0_n_133\ : STD_LOGIC;
  signal \input__0_n_134\ : STD_LOGIC;
  signal \input__0_n_135\ : STD_LOGIC;
  signal \input__0_n_136\ : STD_LOGIC;
  signal \input__0_n_137\ : STD_LOGIC;
  signal \input__0_n_138\ : STD_LOGIC;
  signal \input__0_n_139\ : STD_LOGIC;
  signal \input__0_n_140\ : STD_LOGIC;
  signal \input__0_n_141\ : STD_LOGIC;
  signal \input__0_n_142\ : STD_LOGIC;
  signal \input__0_n_143\ : STD_LOGIC;
  signal \input__0_n_144\ : STD_LOGIC;
  signal \input__0_n_145\ : STD_LOGIC;
  signal \input__0_n_146\ : STD_LOGIC;
  signal \input__0_n_147\ : STD_LOGIC;
  signal \input__0_n_148\ : STD_LOGIC;
  signal \input__0_n_149\ : STD_LOGIC;
  signal \input__0_n_150\ : STD_LOGIC;
  signal \input__0_n_151\ : STD_LOGIC;
  signal \input__0_n_152\ : STD_LOGIC;
  signal \input__0_n_153\ : STD_LOGIC;
  signal \input__0_n_58\ : STD_LOGIC;
  signal \input__0_n_59\ : STD_LOGIC;
  signal \input__0_n_60\ : STD_LOGIC;
  signal \input__0_n_61\ : STD_LOGIC;
  signal \input__0_n_62\ : STD_LOGIC;
  signal \input__0_n_63\ : STD_LOGIC;
  signal \input__0_n_64\ : STD_LOGIC;
  signal \input__0_n_65\ : STD_LOGIC;
  signal \input__0_n_66\ : STD_LOGIC;
  signal \input__0_n_67\ : STD_LOGIC;
  signal \input__0_n_68\ : STD_LOGIC;
  signal \input__0_n_69\ : STD_LOGIC;
  signal \input__0_n_70\ : STD_LOGIC;
  signal \input__0_n_71\ : STD_LOGIC;
  signal \input__0_n_72\ : STD_LOGIC;
  signal \input__0_n_73\ : STD_LOGIC;
  signal \input__0_n_74\ : STD_LOGIC;
  signal \input__0_n_75\ : STD_LOGIC;
  signal \input__0_n_76\ : STD_LOGIC;
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
  signal \zr0_carry__6_i_5_n_0\ : STD_LOGIC;
  signal \zr0_carry__6_i_6_n_0\ : STD_LOGIC;
  signal \zr0_carry__6_i_7_n_0\ : STD_LOGIC;
  signal \zr0_carry__6_i_8_n_0\ : STD_LOGIC;
  signal \zr0_carry__6_n_0\ : STD_LOGIC;
  signal \zr0_carry__6_n_1\ : STD_LOGIC;
  signal \zr0_carry__6_n_2\ : STD_LOGIC;
  signal \zr0_carry__6_n_3\ : STD_LOGIC;
  signal \zr0_carry__7_i_1_n_0\ : STD_LOGIC;
  signal \zr0_carry__7_i_2_n_0\ : STD_LOGIC;
  signal \zr0_carry__7_i_3_n_0\ : STD_LOGIC;
  signal \zr0_carry__7_i_4_n_0\ : STD_LOGIC;
  signal \zr0_carry__7_i_5_n_0\ : STD_LOGIC;
  signal \zr0_carry__7_i_6_n_0\ : STD_LOGIC;
  signal \zr0_carry__7_i_7_n_0\ : STD_LOGIC;
  signal \zr0_carry__7_i_8_n_0\ : STD_LOGIC;
  signal \zr0_carry__7_n_0\ : STD_LOGIC;
  signal \zr0_carry__7_n_1\ : STD_LOGIC;
  signal \zr0_carry__7_n_2\ : STD_LOGIC;
  signal \zr0_carry__7_n_3\ : STD_LOGIC;
  signal \zr0_carry__8_i_1_n_0\ : STD_LOGIC;
  signal \zr0_carry__8_i_2_n_0\ : STD_LOGIC;
  signal \zr0_carry__8_i_3_n_0\ : STD_LOGIC;
  signal \zr0_carry__8_i_4_n_0\ : STD_LOGIC;
  signal \zr0_carry__8_i_5_n_0\ : STD_LOGIC;
  signal \zr0_carry__8_i_6_n_0\ : STD_LOGIC;
  signal \zr0_carry__8_i_7_n_0\ : STD_LOGIC;
  signal \zr0_carry__8_n_1\ : STD_LOGIC;
  signal \zr0_carry__8_n_2\ : STD_LOGIC;
  signal \zr0_carry__8_n_3\ : STD_LOGIC;
  signal zr0_carry_i_1_n_0 : STD_LOGIC;
  signal zr0_carry_i_2_n_0 : STD_LOGIC;
  signal zr0_carry_i_3_n_0 : STD_LOGIC;
  signal zr0_carry_i_4_n_0 : STD_LOGIC;
  signal zr0_carry_i_5_n_0 : STD_LOGIC;
  signal zr0_carry_i_6_n_0 : STD_LOGIC;
  signal zr0_carry_i_7_n_0 : STD_LOGIC;
  signal zr0_carry_n_0 : STD_LOGIC;
  signal zr0_carry_n_1 : STD_LOGIC;
  signal zr0_carry_n_2 : STD_LOGIC;
  signal zr0_carry_n_3 : STD_LOGIC;
  signal zr_1 : STD_LOGIC_VECTOR ( 38 downto 0 );
  signal NLW_input_CARRYCASCOUT_UNCONNECTED : STD_LOGIC;
  signal NLW_input_MULTSIGNOUT_UNCONNECTED : STD_LOGIC;
  signal NLW_input_OVERFLOW_UNCONNECTED : STD_LOGIC;
  signal NLW_input_PATTERNBDETECT_UNCONNECTED : STD_LOGIC;
  signal NLW_input_PATTERNDETECT_UNCONNECTED : STD_LOGIC;
  signal NLW_input_UNDERFLOW_UNCONNECTED : STD_LOGIC;
  signal NLW_input_ACOUT_UNCONNECTED : STD_LOGIC_VECTOR ( 29 downto 0 );
  signal NLW_input_BCOUT_UNCONNECTED : STD_LOGIC_VECTOR ( 17 downto 0 );
  signal NLW_input_CARRYOUT_UNCONNECTED : STD_LOGIC_VECTOR ( 3 downto 0 );
  signal NLW_input_PCOUT_UNCONNECTED : STD_LOGIC_VECTOR ( 47 downto 0 );
  signal \NLW_input__0_CARRYCASCOUT_UNCONNECTED\ : STD_LOGIC;
  signal \NLW_input__0_MULTSIGNOUT_UNCONNECTED\ : STD_LOGIC;
  signal \NLW_input__0_OVERFLOW_UNCONNECTED\ : STD_LOGIC;
  signal \NLW_input__0_PATTERNBDETECT_UNCONNECTED\ : STD_LOGIC;
  signal \NLW_input__0_PATTERNDETECT_UNCONNECTED\ : STD_LOGIC;
  signal \NLW_input__0_UNDERFLOW_UNCONNECTED\ : STD_LOGIC;
  signal \NLW_input__0_ACOUT_UNCONNECTED\ : STD_LOGIC_VECTOR ( 29 downto 0 );
  signal \NLW_input__0_BCOUT_UNCONNECTED\ : STD_LOGIC_VECTOR ( 17 downto 0 );
  signal \NLW_input__0_CARRYOUT_UNCONNECTED\ : STD_LOGIC_VECTOR ( 3 downto 0 );
  signal \NLW_input__1_CARRYCASCOUT_UNCONNECTED\ : STD_LOGIC;
  signal \NLW_input__1_MULTSIGNOUT_UNCONNECTED\ : STD_LOGIC;
  signal \NLW_input__1_OVERFLOW_UNCONNECTED\ : STD_LOGIC;
  signal \NLW_input__1_PATTERNBDETECT_UNCONNECTED\ : STD_LOGIC;
  signal \NLW_input__1_PATTERNDETECT_UNCONNECTED\ : STD_LOGIC;
  signal \NLW_input__1_UNDERFLOW_UNCONNECTED\ : STD_LOGIC;
  signal \NLW_input__1_ACOUT_UNCONNECTED\ : STD_LOGIC_VECTOR ( 29 downto 0 );
  signal \NLW_input__1_BCOUT_UNCONNECTED\ : STD_LOGIC_VECTOR ( 17 downto 0 );
  signal \NLW_input__1_CARRYOUT_UNCONNECTED\ : STD_LOGIC_VECTOR ( 3 downto 0 );
  signal \NLW_input__1_PCOUT_UNCONNECTED\ : STD_LOGIC_VECTOR ( 47 downto 0 );
  signal \NLW_input__10_CARRYCASCOUT_UNCONNECTED\ : STD_LOGIC;
  signal \NLW_input__10_MULTSIGNOUT_UNCONNECTED\ : STD_LOGIC;
  signal \NLW_input__10_OVERFLOW_UNCONNECTED\ : STD_LOGIC;
  signal \NLW_input__10_PATTERNBDETECT_UNCONNECTED\ : STD_LOGIC;
  signal \NLW_input__10_PATTERNDETECT_UNCONNECTED\ : STD_LOGIC;
  signal \NLW_input__10_UNDERFLOW_UNCONNECTED\ : STD_LOGIC;
  signal \NLW_input__10_ACOUT_UNCONNECTED\ : STD_LOGIC_VECTOR ( 29 downto 0 );
  signal \NLW_input__10_BCOUT_UNCONNECTED\ : STD_LOGIC_VECTOR ( 17 downto 0 );
  signal \NLW_input__10_CARRYOUT_UNCONNECTED\ : STD_LOGIC_VECTOR ( 3 downto 0 );
  signal \NLW_input__11_CARRYCASCOUT_UNCONNECTED\ : STD_LOGIC;
  signal \NLW_input__11_MULTSIGNOUT_UNCONNECTED\ : STD_LOGIC;
  signal \NLW_input__11_OVERFLOW_UNCONNECTED\ : STD_LOGIC;
  signal \NLW_input__11_PATTERNBDETECT_UNCONNECTED\ : STD_LOGIC;
  signal \NLW_input__11_PATTERNDETECT_UNCONNECTED\ : STD_LOGIC;
  signal \NLW_input__11_UNDERFLOW_UNCONNECTED\ : STD_LOGIC;
  signal \NLW_input__11_ACOUT_UNCONNECTED\ : STD_LOGIC_VECTOR ( 29 downto 0 );
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
  signal \NLW_input__8_PATTERNBDETECT_UNCONNECTED\ : STD_LOGIC;
  signal \NLW_input__8_PATTERNDETECT_UNCONNECTED\ : STD_LOGIC;
  signal \NLW_input__8_UNDERFLOW_UNCONNECTED\ : STD_LOGIC;
  signal \NLW_input__8_ACOUT_UNCONNECTED\ : STD_LOGIC_VECTOR ( 29 downto 0 );
  signal \NLW_input__8_BCOUT_UNCONNECTED\ : STD_LOGIC_VECTOR ( 17 downto 0 );
  signal \NLW_input__8_CARRYOUT_UNCONNECTED\ : STD_LOGIC_VECTOR ( 3 downto 0 );
  signal \NLW_input__8_PCOUT_UNCONNECTED\ : STD_LOGIC_VECTOR ( 47 downto 0 );
  signal \NLW_input__9_CARRYCASCOUT_UNCONNECTED\ : STD_LOGIC;
  signal \NLW_input__9_MULTSIGNOUT_UNCONNECTED\ : STD_LOGIC;
  signal \NLW_input__9_OVERFLOW_UNCONNECTED\ : STD_LOGIC;
  signal \NLW_input__9_PATTERNBDETECT_UNCONNECTED\ : STD_LOGIC;
  signal \NLW_input__9_PATTERNDETECT_UNCONNECTED\ : STD_LOGIC;
  signal \NLW_input__9_UNDERFLOW_UNCONNECTED\ : STD_LOGIC;
  signal \NLW_input__9_ACOUT_UNCONNECTED\ : STD_LOGIC_VECTOR ( 29 downto 0 );
  signal \NLW_input__9_BCOUT_UNCONNECTED\ : STD_LOGIC_VECTOR ( 17 downto 0 );
  signal \NLW_input__9_CARRYOUT_UNCONNECTED\ : STD_LOGIC_VECTOR ( 3 downto 0 );
  signal \NLW_input__9_PCOUT_UNCONNECTED\ : STD_LOGIC_VECTOR ( 47 downto 0 );
  signal \NLW_iter_reg[13]_i_2_CO_UNCONNECTED\ : STD_LOGIC_VECTOR ( 3 downto 1 );
  signal \NLW_iter_reg[13]_i_2_O_UNCONNECTED\ : STD_LOGIC_VECTOR ( 3 downto 2 );
  signal \NLW_minusOp_carry__2_CO_UNCONNECTED\ : STD_LOGIC_VECTOR ( 3 downto 0 );
  signal \NLW_minusOp_carry__2_O_UNCONNECTED\ : STD_LOGIC_VECTOR ( 3 downto 1 );
  signal \NLW_waiting1__4_carry_O_UNCONNECTED\ : STD_LOGIC_VECTOR ( 3 downto 0 );
  signal \NLW_waiting1__4_carry__0_O_UNCONNECTED\ : STD_LOGIC_VECTOR ( 3 downto 0 );
  signal \NLW_waiting1__4_carry__1_O_UNCONNECTED\ : STD_LOGIC_VECTOR ( 3 downto 0 );
  signal \NLW_waiting1__4_carry__2_O_UNCONNECTED\ : STD_LOGIC_VECTOR ( 3 downto 0 );
  signal \NLW_waiting1__4_carry__3_O_UNCONNECTED\ : STD_LOGIC_VECTOR ( 3 downto 0 );
  signal NLW_waiting1_carry_O_UNCONNECTED : STD_LOGIC_VECTOR ( 3 downto 0 );
  signal \NLW_waiting1_carry__0_CO_UNCONNECTED\ : STD_LOGIC_VECTOR ( 3 downto 1 );
  signal \NLW_waiting1_carry__0_O_UNCONNECTED\ : STD_LOGIC_VECTOR ( 3 downto 0 );
  signal \NLW_waiting2_carry__8_CO_UNCONNECTED\ : STD_LOGIC_VECTOR ( 3 to 3 );
  signal \NLW_zi0_carry__8_CO_UNCONNECTED\ : STD_LOGIC_VECTOR ( 3 to 3 );
  signal \NLW_zr0_carry__8_CO_UNCONNECTED\ : STD_LOGIC_VECTOR ( 3 to 3 );
  attribute METHODOLOGY_DRC_VIOS : string;
  attribute METHODOLOGY_DRC_VIOS of input : label is "{SYNTH-13 {cell *THIS*}}";
  attribute METHODOLOGY_DRC_VIOS of \input__0\ : label is "{SYNTH-10 {cell *THIS*} {string 23x18 5}}";
  attribute METHODOLOGY_DRC_VIOS of \input__1\ : label is "{SYNTH-13 {cell *THIS*}}";
  attribute METHODOLOGY_DRC_VIOS of \input__10\ : label is "{SYNTH-10 {cell *THIS*} {string 23x18 5}}";
  attribute METHODOLOGY_DRC_VIOS of \input__11\ : label is "{SYNTH-13 {cell *THIS*}}";
  attribute METHODOLOGY_DRC_VIOS of \input__12\ : label is "{SYNTH-10 {cell *THIS*} {string 18x18 5}}";
  attribute METHODOLOGY_DRC_VIOS of \input__13\ : label is "{SYNTH-10 {cell *THIS*} {string 18x23 5}}";
  attribute HLUTNM : string;
  attribute HLUTNM of \input__160_carry__10_i_1\ : label is "lutpair28";
  attribute HLUTNM of \input__160_carry__10_i_2\ : label is "lutpair27";
  attribute HLUTNM of \input__160_carry__10_i_3\ : label is "lutpair26";
  attribute HLUTNM of \input__160_carry__10_i_4\ : label is "lutpair25";
  attribute HLUTNM of \input__160_carry__10_i_6\ : label is "lutpair28";
  attribute HLUTNM of \input__160_carry__10_i_7\ : label is "lutpair27";
  attribute HLUTNM of \input__160_carry__10_i_8\ : label is "lutpair26";
  attribute HLUTNM of \input__160_carry__11_i_1\ : label is "lutpair30";
  attribute HLUTNM of \input__160_carry__11_i_2\ : label is "lutpair29";
  attribute HLUTNM of \input__160_carry__11_i_5\ : label is "lutpair31";
  attribute HLUTNM of \input__160_carry__11_i_6\ : label is "lutpair30";
  attribute HLUTNM of \input__160_carry__11_i_7\ : label is "lutpair29";
  attribute HLUTNM of \input__160_carry__12_i_1\ : label is "lutpair34";
  attribute HLUTNM of \input__160_carry__12_i_2\ : label is "lutpair33";
  attribute HLUTNM of \input__160_carry__12_i_3\ : label is "lutpair32";
  attribute HLUTNM of \input__160_carry__12_i_4\ : label is "lutpair31";
  attribute HLUTNM of \input__160_carry__12_i_5\ : label is "lutpair35";
  attribute HLUTNM of \input__160_carry__12_i_6\ : label is "lutpair34";
  attribute HLUTNM of \input__160_carry__12_i_7\ : label is "lutpair33";
  attribute HLUTNM of \input__160_carry__12_i_8\ : label is "lutpair32";
  attribute HLUTNM of \input__160_carry__13_i_1\ : label is "lutpair36";
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
  attribute HLUTNM of \input__316_carry__10_i_4\ : label is "lutpair42";
  attribute HLUTNM of \input__316_carry__10_i_6\ : label is "lutpair45";
  attribute HLUTNM of \input__316_carry__10_i_7\ : label is "lutpair44";
  attribute HLUTNM of \input__316_carry__10_i_8\ : label is "lutpair43";
  attribute HLUTNM of \input__316_carry__11_i_1\ : label is "lutpair47";
  attribute HLUTNM of \input__316_carry__11_i_2\ : label is "lutpair46";
  attribute HLUTNM of \input__316_carry__11_i_5\ : label is "lutpair48";
  attribute HLUTNM of \input__316_carry__11_i_6\ : label is "lutpair47";
  attribute HLUTNM of \input__316_carry__11_i_7\ : label is "lutpair46";
  attribute HLUTNM of \input__316_carry__12_i_1\ : label is "lutpair51";
  attribute HLUTNM of \input__316_carry__12_i_2\ : label is "lutpair50";
  attribute HLUTNM of \input__316_carry__12_i_3\ : label is "lutpair49";
  attribute HLUTNM of \input__316_carry__12_i_4\ : label is "lutpair48";
  attribute HLUTNM of \input__316_carry__12_i_5\ : label is "lutpair52";
  attribute HLUTNM of \input__316_carry__12_i_6\ : label is "lutpair51";
  attribute HLUTNM of \input__316_carry__12_i_7\ : label is "lutpair50";
  attribute HLUTNM of \input__316_carry__12_i_8\ : label is "lutpair49";
  attribute HLUTNM of \input__316_carry__13_i_1\ : label is "lutpair54";
  attribute HLUTNM of \input__316_carry__13_i_2\ : label is "lutpair53";
  attribute HLUTNM of \input__316_carry__13_i_3\ : label is "lutpair52";
  attribute HLUTNM of \input__316_carry__13_i_6\ : label is "lutpair54";
  attribute HLUTNM of \input__316_carry__13_i_7\ : label is "lutpair53";
  attribute HLUTNM of \input__316_carry__8_i_1\ : label is "lutpair37";
  attribute HLUTNM of \input__316_carry__8_i_5\ : label is "lutpair38";
  attribute HLUTNM of \input__316_carry__8_i_6\ : label is "lutpair37";
  attribute HLUTNM of \input__316_carry__9_i_1\ : label is "lutpair41";
  attribute HLUTNM of \input__316_carry__9_i_2\ : label is "lutpair40";
  attribute HLUTNM of \input__316_carry__9_i_3\ : label is "lutpair39";
  attribute HLUTNM of \input__316_carry__9_i_4\ : label is "lutpair38";
  attribute HLUTNM of \input__316_carry__9_i_5\ : label is "lutpair42";
  attribute HLUTNM of \input__316_carry__9_i_6\ : label is "lutpair41";
  attribute HLUTNM of \input__316_carry__9_i_7\ : label is "lutpair40";
  attribute HLUTNM of \input__316_carry__9_i_8\ : label is "lutpair39";
  attribute METHODOLOGY_DRC_VIOS of \input__4\ : label is "{SYNTH-13 {cell *THIS*}}";
  attribute METHODOLOGY_DRC_VIOS of \input__5\ : label is "{SYNTH-10 {cell *THIS*} {string 23x18 5}}";
  attribute METHODOLOGY_DRC_VIOS of \input__6\ : label is "{SYNTH-13 {cell *THIS*}}";
  attribute METHODOLOGY_DRC_VIOS of \input__7\ : label is "{SYNTH-10 {cell *THIS*} {string 18x18 5}}";
  attribute METHODOLOGY_DRC_VIOS of \input__8\ : label is "{SYNTH-10 {cell *THIS*} {string 18x23 5}}";
  attribute METHODOLOGY_DRC_VIOS of \input__9\ : label is "{SYNTH-13 {cell *THIS*}}";
  attribute SOFT_HLUTNM : string;
  attribute SOFT_HLUTNM of int_ready_i_1 : label is "soft_lutpair0";
  attribute SOFT_HLUTNM of \it[13]_i_2\ : label is "soft_lutpair0";
  attribute SOFT_HLUTNM of \it[13]_i_5\ : label is "soft_lutpair6";
  attribute SOFT_HLUTNM of waiting1_carry_i_10 : label is "soft_lutpair2";
  attribute SOFT_HLUTNM of waiting1_carry_i_11 : label is "soft_lutpair4";
  attribute SOFT_HLUTNM of waiting1_carry_i_12 : label is "soft_lutpair5";
  attribute SOFT_HLUTNM of waiting1_carry_i_13 : label is "soft_lutpair4";
  attribute SOFT_HLUTNM of waiting1_carry_i_14 : label is "soft_lutpair6";
  attribute SOFT_HLUTNM of waiting1_carry_i_15 : label is "soft_lutpair5";
  attribute SOFT_HLUTNM of waiting1_carry_i_5 : label is "soft_lutpair1";
  attribute SOFT_HLUTNM of waiting1_carry_i_6 : label is "soft_lutpair2";
  attribute SOFT_HLUTNM of waiting1_carry_i_7 : label is "soft_lutpair1";
  attribute SOFT_HLUTNM of waiting1_carry_i_8 : label is "soft_lutpair3";
  attribute SOFT_HLUTNM of waiting1_carry_i_9 : label is "soft_lutpair3";
begin
  waiting <= \^waiting\;
input: unisim.vcomponents.DSP48E1
    generic map(
      ACASCREG => 0,
      ADREG => 1,
      ALUMODEREG => 0,
      AREG => 0,
      AUTORESET_PATDET => "NO_RESET",
      A_INPUT => "DIRECT",
      BCASCREG => 0,
      BREG => 0,
      B_INPUT => "DIRECT",
      CARRYINREG => 0,
      CARRYINSELREG => 0,
      CREG => 1,
      DREG => 1,
      INMODEREG => 0,
      MASK => X"3FFFFFFFFFFF",
      MREG => 0,
      OPMODEREG => 0,
      PATTERN => X"000000000000",
      PREG => 0,
      SEL_MASK => "MASK",
      SEL_PATTERN => "PATTERN",
      USE_DPORT => false,
      USE_MULT => "MULTIPLY",
      USE_PATTERN_DETECT => "NO_PATDET",
      USE_SIMD => "ONE48"
    )
        port map (
      A(29) => input_i_1_n_0,
      A(28) => input_i_1_n_0,
      A(27) => input_i_8_n_0,
      A(26) => input_i_8_n_0,
      A(25) => input_i_8_n_0,
      A(24) => input_i_8_n_0,
      A(23) => input_i_8_n_0,
      A(22) => input_i_8_n_0,
      A(21 downto 0) => zr_1(38 downto 17),
      ACIN(29 downto 0) => B"000000000000000000000000000000",
      ACOUT(29 downto 0) => NLW_input_ACOUT_UNCONNECTED(29 downto 0),
      ALUMODE(3 downto 0) => B"0000",
      B(17) => input_i_1_n_0,
      B(16) => input_i_1_n_0,
      B(15) => input_i_1_n_0,
      B(14) => input_i_1_n_0,
      B(13) => input_i_1_n_0,
      B(12) => input_i_1_n_0,
      B(11) => input_i_1_n_0,
      B(10) => input_i_1_n_0,
      B(9) => input_i_2_n_0,
      B(8) => input_i_2_n_0,
      B(7) => input_i_2_n_0,
      B(6) => input_i_2_n_0,
      B(5) => input_i_2_n_0,
      B(4 downto 0) => zr_1(38 downto 34),
      BCIN(17 downto 0) => B"000000000000000000",
      BCOUT(17 downto 0) => NLW_input_BCOUT_UNCONNECTED(17 downto 0),
      C(47 downto 0) => B"111111111111111111111111111111111111111111111111",
      CARRYCASCIN => '0',
      CARRYCASCOUT => NLW_input_CARRYCASCOUT_UNCONNECTED,
      CARRYIN => '0',
      CARRYINSEL(2 downto 0) => B"000",
      CARRYOUT(3 downto 0) => NLW_input_CARRYOUT_UNCONNECTED(3 downto 0),
      CEA1 => '0',
      CEA2 => '0',
      CEAD => '0',
      CEALUMODE => '0',
      CEB1 => '0',
      CEB2 => '0',
      CEC => '0',
      CECARRYIN => '0',
      CECTRL => '0',
      CED => '0',
      CEINMODE => '0',
      CEM => '0',
      CEP => '0',
      CLK => '0',
      D(24 downto 0) => B"0000000000000000000000000",
      INMODE(4 downto 0) => B"00000",
      MULTSIGNIN => '0',
      MULTSIGNOUT => NLW_input_MULTSIGNOUT_UNCONNECTED,
      OPMODE(6 downto 0) => B"0000101",
      OVERFLOW => NLW_input_OVERFLOW_UNCONNECTED,
      P(47) => input_n_58,
      P(46) => input_n_59,
      P(45) => input_n_60,
      P(44) => input_n_61,
      P(43) => input_n_62,
      P(42) => input_n_63,
      P(41) => input_n_64,
      P(40) => input_n_65,
      P(39) => input_n_66,
      P(38) => input_n_67,
      P(37) => input_n_68,
      P(36) => input_n_69,
      P(35) => input_n_70,
      P(34) => input_n_71,
      P(33) => input_n_72,
      P(32) => input_n_73,
      P(31) => input_n_74,
      P(30) => input_n_75,
      P(29) => input_n_76,
      P(28) => input_n_77,
      P(27) => input_n_78,
      P(26) => input_n_79,
      P(25) => input_n_80,
      P(24) => input_n_81,
      P(23) => input_n_82,
      P(22) => input_n_83,
      P(21) => input_n_84,
      P(20) => input_n_85,
      P(19) => input_n_86,
      P(18) => input_n_87,
      P(17) => input_n_88,
      P(16) => input_n_89,
      P(15) => input_n_90,
      P(14) => input_n_91,
      P(13) => input_n_92,
      P(12) => input_n_93,
      P(11) => input_n_94,
      P(10) => input_n_95,
      P(9) => input_n_96,
      P(8) => input_n_97,
      P(7) => input_n_98,
      P(6) => input_n_99,
      P(5) => input_n_100,
      P(4) => input_n_101,
      P(3) => input_n_102,
      P(2) => input_n_103,
      P(1) => input_n_104,
      P(0) => input_n_105,
      PATTERNBDETECT => NLW_input_PATTERNBDETECT_UNCONNECTED,
      PATTERNDETECT => NLW_input_PATTERNDETECT_UNCONNECTED,
      PCIN(47 downto 0) => B"000000000000000000000000000000000000000000000000",
      PCOUT(47 downto 0) => NLW_input_PCOUT_UNCONNECTED(47 downto 0),
      RSTA => '0',
      RSTALLCARRYIN => '0',
      RSTALUMODE => '0',
      RSTB => '0',
      RSTC => '0',
      RSTCTRL => '0',
      RSTD => '0',
      RSTINMODE => '0',
      RSTM => '0',
      RSTP => '0',
      UNDERFLOW => NLW_input_UNDERFLOW_UNCONNECTED
    );
\input__0\: unisim.vcomponents.DSP48E1
    generic map(
      ACASCREG => 0,
      ADREG => 1,
      ALUMODEREG => 0,
      AREG => 0,
      AUTORESET_PATDET => "NO_RESET",
      A_INPUT => "DIRECT",
      BCASCREG => 0,
      BREG => 0,
      B_INPUT => "DIRECT",
      CARRYINREG => 0,
      CARRYINSELREG => 0,
      CREG => 1,
      DREG => 1,
      INMODEREG => 0,
      MASK => X"3FFFFFFFFFFF",
      MREG => 0,
      OPMODEREG => 0,
      PATTERN => X"000000000000",
      PREG => 0,
      SEL_MASK => "MASK",
      SEL_PATTERN => "PATTERN",
      USE_DPORT => false,
      USE_MULT => "MULTIPLY",
      USE_PATTERN_DETECT => "NO_PATDET",
      USE_SIMD => "ONE48"
    )
        port map (
      A(29) => input_i_2_n_0,
      A(28) => input_i_2_n_0,
      A(27) => input_i_2_n_0,
      A(26) => input_i_2_n_0,
      A(25) => input_i_2_n_0,
      A(24) => \input__0_i_18_n_0\,
      A(23) => \input__0_i_18_n_0\,
      A(22) => \input__0_i_18_n_0\,
      A(21 downto 0) => zr_1(38 downto 17),
      ACIN(29 downto 0) => B"000000000000000000000000000000",
      ACOUT(29 downto 0) => \NLW_input__0_ACOUT_UNCONNECTED\(29 downto 0),
      ALUMODE(3 downto 0) => B"0000",
      B(17) => '0',
      B(16 downto 0) => zr_1(16 downto 0),
      BCIN(17 downto 0) => B"000000000000000000",
      BCOUT(17 downto 0) => \NLW_input__0_BCOUT_UNCONNECTED\(17 downto 0),
      C(47 downto 0) => B"111111111111111111111111111111111111111111111111",
      CARRYCASCIN => '0',
      CARRYCASCOUT => \NLW_input__0_CARRYCASCOUT_UNCONNECTED\,
      CARRYIN => '0',
      CARRYINSEL(2 downto 0) => B"000",
      CARRYOUT(3 downto 0) => \NLW_input__0_CARRYOUT_UNCONNECTED\(3 downto 0),
      CEA1 => '0',
      CEA2 => '0',
      CEAD => '0',
      CEALUMODE => '0',
      CEB1 => '0',
      CEB2 => '0',
      CEC => '0',
      CECARRYIN => '0',
      CECTRL => '0',
      CED => '0',
      CEINMODE => '0',
      CEM => '0',
      CEP => '0',
      CLK => '0',
      D(24 downto 0) => B"0000000000000000000000000",
      INMODE(4 downto 0) => B"00000",
      MULTSIGNIN => '0',
      MULTSIGNOUT => \NLW_input__0_MULTSIGNOUT_UNCONNECTED\,
      OPMODE(6 downto 0) => B"0000101",
      OVERFLOW => \NLW_input__0_OVERFLOW_UNCONNECTED\,
      P(47) => \input__0_n_58\,
      P(46) => \input__0_n_59\,
      P(45) => \input__0_n_60\,
      P(44) => \input__0_n_61\,
      P(43) => \input__0_n_62\,
      P(42) => \input__0_n_63\,
      P(41) => \input__0_n_64\,
      P(40) => \input__0_n_65\,
      P(39) => \input__0_n_66\,
      P(38) => \input__0_n_67\,
      P(37) => \input__0_n_68\,
      P(36) => \input__0_n_69\,
      P(35) => \input__0_n_70\,
      P(34) => \input__0_n_71\,
      P(33) => \input__0_n_72\,
      P(32) => \input__0_n_73\,
      P(31) => \input__0_n_74\,
      P(30) => \input__0_n_75\,
      P(29) => \input__0_n_76\,
      P(28) => \input__0_n_77\,
      P(27) => \input__0_n_78\,
      P(26) => \input__0_n_79\,
      P(25) => \input__0_n_80\,
      P(24) => \input__0_n_81\,
      P(23) => \input__0_n_82\,
      P(22) => \input__0_n_83\,
      P(21) => \input__0_n_84\,
      P(20) => \input__0_n_85\,
      P(19) => \input__0_n_86\,
      P(18) => \input__0_n_87\,
      P(17) => \input__0_n_88\,
      P(16) => \input__0_n_89\,
      P(15) => \input__0_n_90\,
      P(14) => \input__0_n_91\,
      P(13) => \input__0_n_92\,
      P(12) => \input__0_n_93\,
      P(11) => \input__0_n_94\,
      P(10) => \input__0_n_95\,
      P(9) => \input__0_n_96\,
      P(8) => \input__0_n_97\,
      P(7) => \input__0_n_98\,
      P(6) => \input__0_n_99\,
      P(5) => \input__0_n_100\,
      P(4) => \input__0_n_101\,
      P(3) => \input__0_n_102\,
      P(2) => \input__0_n_103\,
      P(1) => \input__0_n_104\,
      P(0) => \input__0_n_105\,
      PATTERNBDETECT => \NLW_input__0_PATTERNBDETECT_UNCONNECTED\,
      PATTERNDETECT => \NLW_input__0_PATTERNDETECT_UNCONNECTED\,
      PCIN(47 downto 0) => B"000000000000000000000000000000000000000000000000",
      PCOUT(47) => \input__0_n_106\,
      PCOUT(46) => \input__0_n_107\,
      PCOUT(45) => \input__0_n_108\,
      PCOUT(44) => \input__0_n_109\,
      PCOUT(43) => \input__0_n_110\,
      PCOUT(42) => \input__0_n_111\,
      PCOUT(41) => \input__0_n_112\,
      PCOUT(40) => \input__0_n_113\,
      PCOUT(39) => \input__0_n_114\,
      PCOUT(38) => \input__0_n_115\,
      PCOUT(37) => \input__0_n_116\,
      PCOUT(36) => \input__0_n_117\,
      PCOUT(35) => \input__0_n_118\,
      PCOUT(34) => \input__0_n_119\,
      PCOUT(33) => \input__0_n_120\,
      PCOUT(32) => \input__0_n_121\,
      PCOUT(31) => \input__0_n_122\,
      PCOUT(30) => \input__0_n_123\,
      PCOUT(29) => \input__0_n_124\,
      PCOUT(28) => \input__0_n_125\,
      PCOUT(27) => \input__0_n_126\,
      PCOUT(26) => \input__0_n_127\,
      PCOUT(25) => \input__0_n_128\,
      PCOUT(24) => \input__0_n_129\,
      PCOUT(23) => \input__0_n_130\,
      PCOUT(22) => \input__0_n_131\,
      PCOUT(21) => \input__0_n_132\,
      PCOUT(20) => \input__0_n_133\,
      PCOUT(19) => \input__0_n_134\,
      PCOUT(18) => \input__0_n_135\,
      PCOUT(17) => \input__0_n_136\,
      PCOUT(16) => \input__0_n_137\,
      PCOUT(15) => \input__0_n_138\,
      PCOUT(14) => \input__0_n_139\,
      PCOUT(13) => \input__0_n_140\,
      PCOUT(12) => \input__0_n_141\,
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
      I0 => c_real(1),
      I1 => \it[13]_i_3_n_0\,
      I2 => zr(1),
      O => zr_1(1)
    );
\input__0_i_17\: unisim.vcomponents.LUT3
    generic map(
      INIT => X"B8"
    )
        port map (
      I0 => c_real(0),
      I1 => \it[13]_i_3_n_0\,
      I2 => zr(0),
      O => zr_1(0)
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
