DanielKirchner/bachelorarbeit/src/mandel-zybo.srcs/sources_1/bd/top/ip/top_buttons_0_2/top_buttons_0_2_sim_netlist.v

// Copyright 1986-2018 Xilinx, Inc. All Rights Reserved.
// --------------------------------------------------------------------------------
// Tool Version: Vivado v.2018.3 (lin64) Build 2405991 Thu Dec  6 23:36:41 MST 2018
// Date        : Wed Jul  3 16:16:52 2019
// Host        : daniel-pc running 64-bit unknown
// Command     : write_verilog -force -mode funcsim
//               /home/daniel/prg/uni/bachelor/src/mandel-zybo.srcs/sources_1/bd/top/ip/top_buttons_0_2/top_buttons_0_2_sim_netlist.v
// Design      : top_buttons_0_2
// Purpose     : This verilog netlist is a functional simulation representation of the design and should not be modified
//               or synthesized. This netlist cannot be used for SDF annotated simulation.
// Device      : xc7z010clg400-1
// --------------------------------------------------------------------------------
`timescale 1 ps / 1 ps

(* CHECK_LICENSE_TYPE = "top_buttons_0_2,buttons,{}" *) (* downgradeipidentifiedwarnings = "yes" *) (* ip_definition_source = "module_ref" *) 
(* x_core_info = "buttons,Vivado 2018.3" *) 
(* NotValidForBitStream *)
module top_buttons_0_2
   (btns_in,
    btns_out,
    clk,
    reset);
  input [7:0]btns_in;
  output [7:0]btns_out;
  (* x_interface_info = "xilinx.com:signal:clock:1.0 clk CLK" *) (* x_interface_parameter = "XIL_INTERFACENAME clk, ASSOCIATED_RESET reset, FREQ_HZ 125000000, PHASE 0.000, CLK_DOMAIN top_clk, INSERT_VIP 0" *) input clk;
  (* x_interface_info = "xilinx.com:signal:reset:1.0 reset RST" *) (* x_interface_parameter = "XIL_INTERFACENAME reset, POLARITY ACTIVE_HIGH, INSERT_VIP 0" *) input reset;

  wire [7:0]btns_in;
  wire [7:0]btns_out;
  wire clk;
  wire reset;

  top_buttons_0_2_buttons U0
       (.btns_in(btns_in),
        .btns_out(btns_out),
        .clk(clk),
        .reset(reset));
endmodule

(* ORIG_REF_NAME = "buttons" *) 
module top_buttons_0_2_buttons
   (btns_out,
    reset,
    clk,
    btns_in);
  output [7:0]btns_out;
  input reset;
  input clk;
  input [7:0]btns_in;

  wire [7:0]btns_in;
  wire [7:0]btns_out;
  wire clk;
  wire clk_btn_i_1_n_0;
  wire clk_btn_reg_n_0;
  wire [19:0]count;
  wire \count[19]_i_2_n_0 ;
  wire \count[19]_i_3_n_0 ;
  wire \count[19]_i_4_n_0 ;
  wire \count[19]_i_5_n_0 ;
  wire \count[19]_i_6_n_0 ;
  wire [19:0]count_0;
  wire \count_reg[12]_i_2_n_0 ;
  wire \count_reg[12]_i_2_n_1 ;
  wire \count_reg[12]_i_2_n_2 ;
  wire \count_reg[12]_i_2_n_3 ;
  wire \count_reg[16]_i_2_n_0 ;
  wire \count_reg[16]_i_2_n_1 ;
  wire \count_reg[16]_i_2_n_2 ;
  wire \count_reg[16]_i_2_n_3 ;
  wire \count_reg[19]_i_7_n_2 ;
  wire \count_reg[19]_i_7_n_3 ;
  wire \count_reg[4]_i_2_n_0 ;
  wire \count_reg[4]_i_2_n_1 ;
  wire \count_reg[4]_i_2_n_2 ;
  wire \count_reg[4]_i_2_n_3 ;
  wire \count_reg[8]_i_2_n_0 ;
  wire \count_reg[8]_i_2_n_1 ;
  wire \count_reg[8]_i_2_n_2 ;
  wire \count_reg[8]_i_2_n_3 ;
  wire [19:1]data0;
  wire reset;
  wire [3:2]\NLW_count_reg[19]_i_7_CO_UNCONNECTED ;
  wire [3:3]\NLW_count_reg[19]_i_7_O_UNCONNECTED ;

  LUT6 #(
    .INIT(64'hFFFFFFFB00000004)) 
    clk_btn_i_1
       (.I0(\count[19]_i_2_n_0 ),
        .I1(\count[19]_i_3_n_0 ),
        .I2(\count[19]_i_4_n_0 ),
        .I3(\count[19]_i_5_n_0 ),
        .I4(\count[19]_i_6_n_0 ),
        .I5(clk_btn_reg_n_0),
        .O(clk_btn_i_1_n_0));
  FDRE clk_btn_reg
       (.C(clk),
        .CE(1'b1),
        .D(clk_btn_i_1_n_0),
        .Q(clk_btn_reg_n_0),
        .R(reset));
  LUT6 #(
    .INIT(64'h00000000FFFFFFFB)) 
    \count[0]_i_1 
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
        .CYINIT(1'b0),
        .DI({1'b0,1'b0,1'b0,1'b0}),
        .O(data0[8:5]),
        .S(count[8:5]));
  FDRE \count_reg[9] 
       (.C(clk),
        .CE(1'b1),
        .D(count_0[9]),
        .Q(count[9]),
        .R(reset));
  top_buttons_0_2_debounce debounce0
       (.CLK(clk_btn_reg_n_0),
        .btns_in(btns_in[0]),
        .btns_out(btns_out[0]),
        .reset(reset));
  top_buttons_0_2_debounce_0 debounce1
       (.CLK(clk_btn_reg_n_0),
        .btns_in(btns_in[1]),
        .btns_out(btns_out[1]),
        .reset(reset));
  top_buttons_0_2_debounce_1 debounce2
       (.CLK(clk_btn_reg_n_0),
        .btns_in(btns_in[2]),
        .btns_out(btns_out[2]),
        .reset(reset));
  top_buttons_0_2_debounce_2 debounce3
       (.CLK(clk_btn_reg_n_0),
        .btns_in(btns_in[3]),
        .btns_out(btns_out[3]),
        .reset(reset));
  top_buttons_0_2_debounce_3 debounce4
       (.CLK(clk_btn_reg_n_0),
        .btns_in(btns_in[4]),
        .btns_out(btns_out[4]),
        .reset(reset));
  top_buttons_0_2_debounce_4 debounce5
       (.CLK(clk_btn_reg_n_0),
        .btns_in(btns_in[5]),
        .btns_out(btns_out[5]),
        .reset(reset));
  top_buttons_0_2_debounce_5 debounce6
       (.CLK(clk_btn_reg_n_0),
        .btns_in(btns_in[6]),
        .btns_out(btns_out[6]),
        .reset(reset));
  top_buttons_0_2_debounce_6 debounce7
       (.CLK(clk_btn_reg_n_0),
        .btns_in(btns_in[7]),
        .btns_out(btns_out[7]),
        .reset(reset));
endmodule

(* ORIG_REF_NAME = "debounce" *) 
module top_buttons_0_2_debounce
   (btns_out,
    reset,
    CLK,
    btns_in);
  output [0:0]btns_out;
  input reset;
  input CLK;
  input [0:0]btns_in;

  wire CLK;
  wire btn_out;
  wire btn_out_i_2_n_0;
  wire [0:0]btns_in;
  wire [0:0]btns_out;
  wire reset;
  wire [9:0]sreg;
  wire \sreg[4]_i_2_n_0 ;
  wire \sreg[5]_i_2_n_0 ;
  wire \sreg[6]_i_2_n_0 ;
  wire [9:0]sreg_0;

  LUT5 #(
    .INIT(32'h00000010)) 
    btn_out_i_1
       (.I0(sreg[7]),
        .I1(sreg[8]),
        .I2(btn_out_i_2_n_0),
        .I3(sreg[6]),
        .I4(sreg[9]),
        .O(btn_out));
  LUT6 #(
    .INIT(64'h0000000000004000)) 
    btn_out_i_2
       (.I0(sreg[3]),
        .I1(sreg[2]),
        .I2(sreg[1]),
        .I3(sreg[0]),
        .I4(sreg[5]),
        .I5(sreg[4]),
        .O(btn_out_i_2_n_0));
  FDRE btn_out_reg
       (.C(CLK),
        .CE(1'b1),
        .D(btn_out),
        .Q(btns_out),
        .R(reset));
  LUT6 #(
    .INIT(64'hFFFFFFFF00000010)) 
    \sreg[0]_i_1 
       (.I0(sreg[9]),
        .I1(sreg[6]),
        .I2(btn_out_i_2_n_0),
        .I3(sreg[8]),
        .I4(sreg[7]),
        .I5(btns_in),
        .O(sreg_0[0]));
  LUT6 #(
    .INIT(64'hFF00FF01FF00FE00)) 
    \sreg[4]_i_1 
       (.I0(sreg[9]),
        .I1(sreg[7]),
        .I2(sreg[6]),
        .I3(sreg[3]),
        .I4(sreg[8]),
        .I5(\sreg[4]_i_2_n_0 ),
        .O(sreg_0[4]));
  LUT6 #(
    .INIT(64'hFFFFFFFF10000000)) 
    \sreg[4]_i_2 
       (.I0(sreg[4]),
        .I1(sreg[5]),
        .I2(sreg[0]),
        .I3(sreg[1]),
        .I4(sreg[2]),
        .I5(sreg[3]),
        .O(\sreg[4]_i_2_n_0 ));
  LUT6 #(
    .INIT(64'hFFFFFFFF00010000)) 
    \sreg[5]_i_1 
       (.I0(sreg[9]),
        .I1(sreg[7]),
        .I2(sreg[6]),
        .I3(sreg[8]),
        .I4(\sreg[5]_i_2_n_0 ),
        .I5(sreg[4]),
        .O(sreg_0[5]));
  LUT5 #(
    .INIT(32'h00004000)) 
    \sreg[5]_i_2 
       (.I0(sreg[5]),
        .I1(sreg[0]),
        .I2(sreg[1]),
        .I3(sreg[2]),
        .I4(sreg[3]),
        .O(\sreg[5]_i_2_n_0 ));
  LUT6 #(
    .INIT(64'hFF00FF01FF00FE00)) 
    \sreg[6]_i_1 
       (.I0(sreg[9]),
        .I1(sreg[7]),
        .I2(sreg[6]),
        .I3(sreg[5]),
        .I4(sreg[8]),
        .I5(\sreg[6]_i_2_n_0 ),
        .O(sreg_0[6]));
  LUT6 #(
    .INIT(64'hFFFFFFFF10000000)) 
    \sreg[6]_i_2 
       (.I0(sreg[4]),
        .I1(sreg[3]),
        .I2(sreg[2]),
        .I3(sreg[1]),
        .I4(sreg[0]),
        .I5(sreg[5]),
        .O(\sreg[6]_i_2_n_0 ));
  (* SOFT_HLUTNM = "soft_lutpair0" *) 
  LUT5 #(
    .INIT(32'hFFFF0100)) 
    \sreg[7]_i_1 
       (.I0(sreg[9]),
        .I1(sreg[7]),
        .I2(sreg[8]),
        .I3(btn_out_i_2_n_0),
        .I4(sreg[6]),
        .O(sreg_0[7]));
  (* SOFT_HLUTNM = "soft_lutpair0" *) 
  LUT5 #(
    .INIT(32'hFFFF0010)) 
    \sreg[8]_i_1 
       (.I0(sreg[9]),
        .I1(sreg[6]),
        .I2(btn_out_i_2_n_0),
        .I3(sreg[8]),
        .I4(sreg[7]),
        .O(sreg_0[8]));
  LUT5 #(
    .INIT(32'hFFFF0100)) 
    \sreg[9]_i_1 
       (.I0(sreg[9]),
        .I1(sreg[7]),
        .I2(sreg[6]),
        .I3(btn_out_i_2_n_0),
        .I4(sreg[8]),
        .O(sreg_0[9]));
  FDSE \sreg_reg[0] 
       (.C(CLK),
        .CE(1'b1),
        .D(sreg_0[0]),
        .Q(sreg[0]),
        .S(reset));
  FDSE \sreg_reg[1] 
       (.C(CLK),
        .CE(1'b1),
        .D(sreg[0]),
        .Q(sreg[1]),
        .S(reset));
  FDSE \sreg_reg[2] 
       (.C(CLK),
        .CE(1'b1),
        .D(sreg[1]),
        .Q(sreg[2]),
        .S(reset));
  FDSE \sreg_reg[3] 
       (.C(CLK),
        .CE(1'b1),
        .D(sreg[2]),
        .Q(sreg[3]),
        .S(reset));
  FDSE \sreg_reg[4] 
       (.C(CLK),
        .CE(1'b1),
        .D(sreg_0[4]),
        .Q(sreg[4]),
        .S(reset));
  FDSE \sreg_reg[5] 
       (.C(CLK),
        .CE(1'b1),
        .D(sreg_0[5]),
        .Q(sreg[5]),
        .S(reset));
  FDSE \sreg_reg[6] 
       (.C(CLK),
        .CE(1'b1),
        .D(sreg_0[6]),
        .Q(sreg[6]),
        .S(reset));
  FDSE \sreg_reg[7] 
       (.C(CLK),
        .CE(1'b1),
        .D(sreg_0[7]),
        .Q(sreg[7]),
        .S(reset));
  FDSE \sreg_reg[8] 
       (.C(CLK),
        .CE(1'b1),
        .D(sreg_0[8]),
        .Q(sreg[8]),
        .S(reset));
  FDSE \sreg_reg[9] 
       (.C(CLK),
        .CE(1'b1),
        .D(sreg_0[9]),
        .Q(sreg[9]),
        .S(reset));
endmodule

(* ORIG_REF_NAME = "debounce" *) 
module top_buttons_0_2_debounce_0
   (btns_out,
    reset,
    CLK,
    btns_in);
  output [0:0]btns_out;
  input reset;
  input CLK;
  input [0:0]btns_in;

  wire CLK;
  wire btn_out;
  wire btn_out_i_2__0_n_0;
  wire [0:0]btns_in;
  wire [0:0]btns_out;
  wire reset;
  wire [9:0]sreg;
  wire \sreg[4]_i_2__0_n_0 ;
  wire \sreg[5]_i_2__0_n_0 ;
  wire \sreg[6]_i_2__0_n_0 ;
  wire \sreg_reg_n_0_[3] ;
  wire \sreg_reg_n_0_[4] ;
  wire \sreg_reg_n_0_[5] ;
  wire \sreg_reg_n_0_[6] ;
  wire \sreg_reg_n_0_[7] ;
  wire \sreg_reg_n_0_[8] ;
  wire \sreg_reg_n_0_[9] ;

  LUT5 #(
    .INIT(32'h00000010)) 
    btn_out_i_1__0
       (.I0(\sreg_reg_n_0_[7] ),
        .I1(\sreg_reg_n_0_[8] ),
        .I2(btn_out_i_2__0_n_0),
        .I3(\sreg_reg_n_0_[6] ),
        .I4(\sreg_reg_n_0_[9] ),
        .O(btn_out));
  LUT6 #(
    .INIT(64'h0000000000004000)) 
    btn_out_i_2__0
       (.I0(\sreg_reg_n_0_[3] ),
        .I1(sreg[3]),
        .I2(sreg[2]),
        .I3(sreg[1]),
        .I4(\sreg_reg_n_0_[5] ),
        .I5(\sreg_reg_n_0_[4] ),
        .O(btn_out_i_2__0_n_0));
  FDRE btn_out_reg
       (.C(CLK),
        .CE(1'b1),
        .D(btn_out),
        .Q(btns_out),
        .R(reset));
  LUT6 #(
    .INIT(64'hFFFFFFFF00000010)) 
    \sreg[0]_i_1__0 
       (.I0(\sreg_reg_n_0_[9] ),
        .I1(\sreg_reg_n_0_[6] ),
        .I2(btn_out_i_2__0_n_0),
        .I3(\sreg_reg_n_0_[8] ),
        .I4(\sreg_reg_n_0_[7] ),
        .I5(btns_in),
        .O(sreg[0]));
  LUT6 #(
    .INIT(64'hFF00FF01FF00FE00)) 
    \sreg[4]_i_1__0 
       (.I0(\sreg_reg_n_0_[9] ),
        .I1(\sreg_reg_n_0_[7] ),
        .I2(\sreg_reg_n_0_[6] ),
        .I3(\sreg_reg_n_0_[3] ),
        .I4(\sreg_reg_n_0_[8] ),
        .I5(\sreg[4]_i_2__0_n_0 ),
        .O(sreg[4]));
  LUT6 #(
    .INIT(64'hFFFFFFFF10000000)) 
    \sreg[4]_i_2__0 
       (.I0(\sreg_reg_n_0_[4] ),
        .I1(\sreg_reg_n_0_[5] ),
        .I2(sreg[1]),
        .I3(sreg[2]),
        .I4(sreg[3]),
        .I5(\sreg_reg_n_0_[3] ),
        .O(\sreg[4]_i_2__0_n_0 ));
  LUT6 #(
    .INIT(64'hFFFFFFFF00010000)) 
    \sreg[5]_i_1__0 
       (.I0(\sreg_reg_n_0_[9] ),
        .I1(\sreg_reg_n_0_[7] ),
        .I2(\sreg_reg_n_0_[6] ),
        .I3(\sreg_reg_n_0_[8] ),
        .I4(\sreg[5]_i_2__0_n_0 ),
        .I5(\sreg_reg_n_0_[4] ),
        .O(sreg[5]));
  LUT5 #(
    .INIT(32'h00004000)) 
    \sreg[5]_i_2__0 
       (.I0(\sreg_reg_n_0_[5] ),
        .I1(sreg[1]),
        .I2(sreg[2]),
        .I3(sreg[3]),
        .I4(\sreg_reg_n_0_[3] ),
        .O(\sreg[5]_i_2__0_n_0 ));
  LUT6 #(
    .INIT(64'hFF00FF01FF00FE00)) 
    \sreg[6]_i_1__0 
       (.I0(\sreg_reg_n_0_[9] ),
        .I1(\sreg_reg_n_0_[7] ),
        .I2(\sreg_reg_n_0_[6] ),
        .I3(\sreg_reg_n_0_[5] ),
        .I4(\sreg_reg_n_0_[8] ),
        .I5(\sreg[6]_i_2__0_n_0 ),
        .O(sreg[6]));
  LUT6 #(
    .INIT(64'hFFFFFFFF10000000)) 
    \sreg[6]_i_2__0 
       (.I0(\sreg_reg_n_0_[4] ),
        .I1(\sreg_reg_n_0_[3] ),
        .I2(sreg[3]),
        .I3(sreg[2]),
        .I4(sreg[1]),
        .I5(\sreg_reg_n_0_[5] ),
        .O(\sreg[6]_i_2__0_n_0 ));
  (* SOFT_HLUTNM = "soft_lutpair1" *) 
  LUT5 #(
    .INIT(32'hFFFF0100)) 
    \sreg[7]_i_1__0 
       (.I0(\sreg_reg_n_0_[9] ),
        .I1(\sreg_reg_n_0_[7] ),
        .I2(\sreg_reg_n_0_[8] ),
        .I3(btn_out_i_2__0_n_0),
        .I4(\sreg_reg_n_0_[6] ),
        .O(sreg[7]));
  (* SOFT_HLUTNM = "soft_lutpair1" *) 
  LUT5 #(
    .INIT(32'hFFFF0010)) 
    \sreg[8]_i_1__0 
       (.I0(\sreg_reg_n_0_[9] ),
        .I1(\sreg_reg_n_0_[6] ),
        .I2(btn_out_i_2__0_n_0),
        .I3(\sreg_reg_n_0_[8] ),
        .I4(\sreg_reg_n_0_[7] ),
        .O(sreg[8]));
  LUT5 #(
    .INIT(32'hFFFF0100)) 
    \sreg[9]_i_1__0 
       (.I0(\sreg_reg_n_0_[9] ),
        .I1(\sreg_reg_n_0_[7] ),
        .I2(\sreg_reg_n_0_[6] ),
        .I3(btn_out_i_2__0_n_0),
        .I4(\sreg_reg_n_0_[8] ),
        .O(sreg[9]));
  FDSE \sreg_reg[0] 
       (.C(CLK),
        .CE(1'b1),
        .D(sreg[0]),
        .Q(sreg[1]),
        .S(reset));
  FDSE \sreg_reg[1] 
       (.C(CLK),
        .CE(1'b1),
        .D(sreg[1]),
        .Q(sreg[2]),
        .S(reset));
  FDSE \sreg_reg[2] 
       (.C(CLK),
        .CE(1'b1),
        .D(sreg[2]),
        .Q(sreg[3]),
        .S(reset));
  FDSE \sreg_reg[3] 
       (.C(CLK),
        .CE(1'b1),
        .D(sreg[3]),
        .Q(\sreg_reg_n_0_[3] ),
        .S(reset));
  FDSE \sreg_reg[4] 
       (.C(CLK),
        .CE(1'b1),
        .D(sreg[4]),
        .Q(\sreg_reg_n_0_[4] ),
        .S(reset));
  FDSE \sreg_reg[5] 
       (.C(CLK),
        .CE(1'b1),
        .D(sreg[5]),
        .Q(\sreg_reg_n_0_[5] ),
        .S(reset));
  FDSE \sreg_reg[6] 
       (.C(CLK),
        .CE(1'b1),
        .D(sreg[6]),
        .Q(\sreg_reg_n_0_[6] ),
        .S(reset));
  FDSE \sreg_reg[7] 
       (.C(CLK),
        .CE(1'b1),
        .D(sreg[7]),
        .Q(\sreg_reg_n_0_[7] ),
        .S(reset));
  FDSE \sreg_reg[8] 
       (.C(CLK),
        .CE(1'b1),
        .D(sreg[8]),
        .Q(\sreg_reg_n_0_[8] ),
        .S(reset));
  FDSE \sreg_reg[9] 
       (.C(CLK),
        .CE(1'b1),
        .D(sreg[9]),
        .Q(\sreg_reg_n_0_[9] ),
        .S(reset));
endmodule

(* ORIG_REF_NAME = "debounce" *) 
module top_buttons_0_2_debounce_1
   (btns_out,
    reset,
    CLK,
    btns_in);
  output [0:0]btns_out;
  input reset;
  input CLK;
  input [0:0]btns_in;

  wire CLK;
  wire btn_out;
  wire btn_out_i_2__1_n_0;
  wire [0:0]btns_in;
  wire [0:0]btns_out;
  wire reset;
  wire [9:0]sreg;
  wire \sreg[4]_i_2__1_n_0 ;
  wire \sreg[5]_i_2__1_n_0 ;
  wire \sreg[6]_i_2__1_n_0 ;
  wire \sreg_reg_n_0_[3] ;
  wire \sreg_reg_n_0_[4] ;
  wire \sreg_reg_n_0_[5] ;
  wire \sreg_reg_n_0_[6] ;
  wire \sreg_reg_n_0_[7] ;
  wire \sreg_reg_n_0_[8] ;
  wire \sreg_reg_n_0_[9] ;

  LUT5 #(
    .INIT(32'h00000010)) 
    btn_out_i_1__1
       (.I0(\sreg_reg_n_0_[7] ),
        .I1(\sreg_reg_n_0_[8] ),
        .I2(btn_out_i_2__1_n_0),
        .I3(\sreg_reg_n_0_[6] ),
        .I4(\sreg_reg_n_0_[9] ),
        .O(btn_out));
  LUT6 #(
    .INIT(64'h0000000000004000)) 
    btn_out_i_2__1
       (.I0(\sreg_reg_n_0_[3] ),
        .I1(sreg[3]),
        .I2(sreg[2]),
        .I3(sreg[1]),
        .I4(\sreg_reg_n_0_[5] ),
        .I5(\sreg_reg_n_0_[4] ),
        .O(btn_out_i_2__1_n_0));
  FDRE btn_out_reg
       (.C(CLK),
        .CE(1'b1),
        .D(btn_out),
        .Q(btns_out),
        .R(reset));
  LUT6 #(
    .INIT(64'hFFFFFFFF00000010)) 
    \sreg[0]_i_1__1 
       (.I0(\sreg_reg_n_0_[9] ),
        .I1(\sreg_reg_n_0_[6] ),
        .I2(btn_out_i_2__1_n_0),
        .I3(\sreg_reg_n_0_[8] ),
        .I4(\sreg_reg_n_0_[7] ),
        .I5(btns_in),
        .O(sreg[0]));
  LUT6 #(
    .INIT(64'hFF00FF01FF00FE00)) 
    \sreg[4]_i_1__1 
       (.I0(\sreg_reg_n_0_[9] ),
        .I1(\sreg_reg_n_0_[7] ),
        .I2(\sreg_reg_n_0_[6] ),
        .I3(\sreg_reg_n_0_[3] ),
        .I4(\sreg_reg_n_0_[8] ),
        .I5(\sreg[4]_i_2__1_n_0 ),
        .O(sreg[4]));
  LUT6 #(
    .INIT(64'hFFFFFFFF10000000)) 
    \sreg[4]_i_2__1 
       (.I0(\sreg_reg_n_0_[4] ),
        .I1(\sreg_reg_n_0_[5] ),
        .I2(sreg[1]),
        .I3(sreg[2]),
        .I4(sreg[3]),
        .I5(\sreg_reg_n_0_[3] ),
        .O(\sreg[4]_i_2__1_n_0 ));
  LUT6 #(
    .INIT(64'hFFFFFFFF00010000)) 
    \sreg[5]_i_1__1 
       (.I0(\sreg_reg_n_0_[9] ),
        .I1(\sreg_reg_n_0_[7] ),
        .I2(\sreg_reg_n_0_[6] ),
        .I3(\sreg_reg_n_0_[8] ),
        .I4(\sreg[5]_i_2__1_n_0 ),
        .I5(\sreg_reg_n_0_[4] ),
        .O(sreg[5]));
  LUT5 #(
    .INIT(32'h00004000)) 
    \sreg[5]_i_2__1 
       (.I0(\sreg_reg_n_0_[5] ),
        .I1(sreg[1]),
        .I2(sreg[2]),
        .I3(sreg[3]),
        .I4(\sreg_reg_n_0_[3] ),
        .O(\sreg[5]_i_2__1_n_0 ));
  LUT6 #(
    .INIT(64'hFF00FF01FF00FE00)) 
    \sreg[6]_i_1__1 
       (.I0(\sreg_reg_n_0_[9] ),
        .I1(\sreg_reg_n_0_[7] ),
        .I2(\sreg_reg_n_0_[6] ),
        .I3(\sreg_reg_n_0_[5] ),
        .I4(\sreg_reg_n_0_[8] ),
        .I5(\sreg[6]_i_2__1_n_0 ),
        .O(sreg[6]));
  LUT6 #(
    .INIT(64'hFFFFFFFF10000000)) 
    \sreg[6]_i_2__1 
       (.I0(\sreg_reg_n_0_[4] ),
        .I1(\sreg_reg_n_0_[3] ),
        .I2(sreg[3]),
        .I3(sreg[2]),
        .I4(sreg[1]),
        .I5(\sreg_reg_n_0_[5] ),
        .O(\sreg[6]_i_2__1_n_0 ));
  (* SOFT_HLUTNM = "soft_lutpair2" *) 
  LUT5 #(
    .INIT(32'hFFFF0100)) 
    \sreg[7]_i_1__1 
       (.I0(\sreg_reg_n_0_[9] ),
        .I1(\sreg_reg_n_0_[7] ),
        .I2(\sreg_reg_n_0_[8] ),
        .I3(btn_out_i_2__1_n_0),
        .I4(\sreg_reg_n_0_[6] ),
        .O(sreg[7]));
  (* SOFT_HLUTNM = "soft_lutpair2" *) 
  LUT5 #(
    .INIT(32'hFFFF0010)) 
    \sreg[8]_i_1__1 
       (.I0(\sreg_reg_n_0_[9] ),
        .I1(\sreg_reg_n_0_[6] ),
        .I2(btn_out_i_2__1_n_0),
        .I3(\sreg_reg_n_0_[8] ),
        .I4(\sreg_reg_n_0_[7] ),
        .O(sreg[8]));
  LUT5 #(
    .INIT(32'hFFFF0100)) 
    \sreg[9]_i_1__1 
       (.I0(\sreg_reg_n_0_[9] ),
        .I1(\sreg_reg_n_0_[7] ),
        .I2(\sreg_reg_n_0_[6] ),
        .I3(btn_out_i_2__1_n_0),
        .I4(\sreg_reg_n_0_[8] ),
        .O(sreg[9]));
  FDSE \sreg_reg[0] 
       (.C(CLK),
        .CE(1'b1),
        .D(sreg[0]),
        .Q(sreg[1]),
        .S(reset));
  FDSE \sreg_reg[1] 
       (.C(CLK),
        .CE(1'b1),
        .D(sreg[1]),
        .Q(sreg[2]),
        .S(reset));
  FDSE \sreg_reg[2] 
       (.C(CLK),
        .CE(1'b1),
        .D(sreg[2]),
        .Q(sreg[3]),
        .S(reset));
  FDSE \sreg_reg[3] 
       (.C(CLK),
        .CE(1'b1),
        .D(sreg[3]),
        .Q(\sreg_reg_n_0_[3] ),
        .S(reset));
  FDSE \sreg_reg[4] 
       (.C(CLK),
        .CE(1'b1),
        .D(sreg[4]),
        .Q(\sreg_reg_n_0_[4] ),
        .S(reset));
  FDSE \sreg_reg[5] 
       (.C(CLK),
        .CE(1'b1),
        .D(sreg[5]),
        .Q(\sreg_reg_n_0_[5] ),
        .S(reset));
  FDSE \sreg_reg[6] 
       (.C(CLK),
        .CE(1'b1),
        .D(sreg[6]),
        .Q(\sreg_reg_n_0_[6] ),
        .S(reset));
  FDSE \sreg_reg[7] 
       (.C(CLK),
        .CE(1'b1),
        .D(sreg[7]),
        .Q(\sreg_reg_n_0_[7] ),
        .S(reset));
  FDSE \sreg_reg[8] 
       (.C(CLK),
        .CE(1'b1),
        .D(sreg[8]),
        .Q(\sreg_reg_n_0_[8] ),
        .S(reset));
  FDSE \sreg_reg[9] 
       (.C(CLK),
        .CE(1'b1),
        .D(sreg[9]),
        .Q(\sreg_reg_n_0_[9] ),
        .S(reset));
endmodule

(* ORIG_REF_NAME = "debounce" *) 
module top_buttons_0_2_debounce_2
   (btns_out,
    reset,
    CLK,
    btns_in);
  output [0:0]btns_out;
  input reset;
  input CLK;
  input [0:0]btns_in;

  wire CLK;
  wire btn_out;
  wire btn_out_i_2__2_n_0;
  wire [0:0]btns_in;
  wire [0:0]btns_out;
  wire reset;
  wire [9:0]sreg;
  wire \sreg[4]_i_2__2_n_0 ;
  wire \sreg[5]_i_2__2_n_0 ;
  wire \sreg[6]_i_2__2_n_0 ;
  wire \sreg_reg_n_0_[3] ;
  wire \sreg_reg_n_0_[4] ;
  wire \sreg_reg_n_0_[5] ;
  wire \sreg_reg_n_0_[6] ;
  wire \sreg_reg_n_0_[7] ;
  wire \sreg_reg_n_0_[8] ;
  wire \sreg_reg_n_0_[9] ;

  LUT5 #(
    .INIT(32'h00000010)) 
    btn_out_i_1__2
       (.I0(\sreg_reg_n_0_[7] ),
        .I1(\sreg_reg_n_0_[8] ),
        .I2(btn_out_i_2__2_n_0),
        .I3(\sreg_reg_n_0_[6] ),
        .I4(\sreg_reg_n_0_[9] ),
        .O(btn_out));
  LUT6 #(
    .INIT(64'h0000000000004000)) 
    btn_out_i_2__2
       (.I0(\sreg_reg_n_0_[3] ),
        .I1(sreg[3]),
        .I2(sreg[2]),
        .I3(sreg[1]),
        .I4(\sreg_reg_n_0_[5] ),
        .I5(\sreg_reg_n_0_[4] ),
        .O(btn_out_i_2__2_n_0));
  FDRE btn_out_reg
       (.C(CLK),
        .CE(1'b1),
        .D(btn_out),
        .Q(btns_out),
        .R(reset));
  LUT6 #(
    .INIT(64'hFFFFFFFF00000010)) 
    \sreg[0]_i_1__2 
       (.I0(\sreg_reg_n_0_[9] ),
        .I1(\sreg_reg_n_0_[6] ),
        .I2(btn_out_i_2__2_n_0),
        .I3(\sreg_reg_n_0_[8] ),
        .I4(\sreg_reg_n_0_[7] ),
        .I5(btns_in),
        .O(sreg[0]));
  LUT6 #(
    .INIT(64'hFF00FF01FF00FE00)) 
    \sreg[4]_i_1__2 
       (.I0(\sreg_reg_n_0_[9] ),
        .I1(\sreg_reg_n_0_[7] ),
        .I2(\sreg_reg_n_0_[6] ),
        .I3(\sreg_reg_n_0_[3] ),
        .I4(\sreg_reg_n_0_[8] ),
        .I5(\sreg[4]_i_2__2_n_0 ),
        .O(sreg[4]));
  LUT6 #(
    .INIT(64'hFFFFFFFF10000000)) 
    \sreg[4]_i_2__2 
       (.I0(\sreg_reg_n_0_[4] ),
        .I1(\sreg_reg_n_0_[5] ),
        .I2(sreg[1]),
        .I3(sreg[2]),
        .I4(sreg[3]),
        .I5(\sreg_reg_n_0_[3] ),
        .O(\sreg[4]_i_2__2_n_0 ));
  LUT6 #(
    .INIT(64'hFFFFFFFF00010000)) 
    \sreg[5]_i_1__2 
       (.I0(\sreg_reg_n_0_[9] ),
        .I1(\sreg_reg_n_0_[7] ),
        .I2(\sreg_reg_n_0_[6] ),
        .I3(\sreg_reg_n_0_[8] ),
        .I4(\sreg[5]_i_2__2_n_0 ),
        .I5(\sreg_reg_n_0_[4] ),
        .O(sreg[5]));
  LUT5 #(
    .INIT(32'h00004000)) 
    \sreg[5]_i_2__2 
       (.I0(\sreg_reg_n_0_[5] ),
        .I1(sreg[1]),
        .I2(sreg[2]),
        .I3(sreg[3]),
        .I4(\sreg_reg_n_0_[3] ),
        .O(\sreg[5]_i_2__2_n_0 ));
  LUT6 #(
    .INIT(64'hFF00FF01FF00FE00)) 
    \sreg[6]_i_1__2 
       (.I0(\sreg_reg_n_0_[9] ),
        .I1(\sreg_reg_n_0_[7] ),
        .I2(\sreg_reg_n_0_[6] ),
        .I3(\sreg_reg_n_0_[5] ),
        .I4(\sreg_reg_n_0_[8] ),
        .I5(\sreg[6]_i_2__2_n_0 ),
        .O(sreg[6]));
  LUT6 #(
    .INIT(64'hFFFFFFFF10000000)) 
    \sreg[6]_i_2__2 
       (.I0(\sreg_reg_n_0_[4] ),
        .I1(\sreg_reg_n_0_[3] ),
        .I2(sreg[3]),
        .I3(sreg[2]),
        .I4(sreg[1]),
        .I5(\sreg_reg_n_0_[5] ),
        .O(\sreg[6]_i_2__2_n_0 ));
  (* SOFT_HLUTNM = "soft_lutpair3" *) 
  LUT5 #(
    .INIT(32'hFFFF0100)) 
    \sreg[7]_i_1__2 
       (.I0(\sreg_reg_n_0_[9] ),
        .I1(\sreg_reg_n_0_[7] ),
        .I2(\sreg_reg_n_0_[8] ),
        .I3(btn_out_i_2__2_n_0),
        .I4(\sreg_reg_n_0_[6] ),
        .O(sreg[7]));
  (* SOFT_HLUTNM = "soft_lutpair3" *) 
  LUT5 #(
    .INIT(32'hFFFF0010)) 
    \sreg[8]_i_1__2 
       (.I0(\sreg_reg_n_0_[9] ),
        .I1(\sreg_reg_n_0_[6] ),
        .I2(btn_out_i_2__2_n_0),
        .I3(\sreg_reg_n_0_[8] ),
        .I4(\sreg_reg_n_0_[7] ),
        .O(sreg[8]));
  LUT5 #(
    .INIT(32'hFFFF0100)) 
    \sreg[9]_i_1__2 
       (.I0(\sreg_reg_n_0_[9] ),
        .I1(\sreg_reg_n_0_[7] ),
        .I2(\sreg_reg_n_0_[6] ),
        .I3(btn_out_i_2__2_n_0),
        .I4(\sreg_reg_n_0_[8] ),
        .O(sreg[9]));
  FDSE \sreg_reg[0] 
       (.C(CLK),
        .CE(1'b1),
        .D(sreg[0]),
        .Q(sreg[1]),
        .S(reset));
  FDSE \sreg_reg[1] 
       (.C(CLK),
        .CE(1'b1),
        .D(sreg[1]),
        .Q(sreg[2]),
        .S(reset));
  FDSE \sreg_reg[2] 
       (.C(CLK),
        .CE(1'b1),
        .D(sreg[2]),
        .Q(sreg[3]),
        .S(reset));
  FDSE \sreg_reg[3] 
       (.C(CLK),
        .CE(1'b1),
        .D(sreg[3]),
        .Q(\sreg_reg_n_0_[3] ),
        .S(reset));
  FDSE \sreg_reg[4] 
       (.C(CLK),
        .CE(1'b1),
        .D(sreg[4]),
        .Q(\sreg_reg_n_0_[4] ),
        .S(reset));
  FDSE \sreg_reg[5] 
       (.C(CLK),
        .CE(1'b1),
        .D(sreg[5]),
        .Q(\sreg_reg_n_0_[5] ),
        .S(reset));
  FDSE \sreg_reg[6] 
       (.C(CLK),
        .CE(1'b1),
        .D(sreg[6]),
        .Q(\sreg_reg_n_0_[6] ),
        .S(reset));
  FDSE \sreg_reg[7] 
       (.C(CLK),
        .CE(1'b1),
        .D(sreg[7]),
        .Q(\sreg_reg_n_0_[7] ),
        .S(reset));
  FDSE \sreg_reg[8] 
       (.C(CLK),
        .CE(1'b1),
        .D(sreg[8]),
        .Q(\sreg_reg_n_0_[8] ),
        .S(reset));
  FDSE \sreg_reg[9] 
       (.C(CLK),
        .CE(1'b1),
        .D(sreg[9]),
        .Q(\sreg_reg_n_0_[9] ),
        .S(reset));
endmodule

(* ORIG_REF_NAME = "debounce" *) 
module top_buttons_0_2_debounce_3
   (btns_out,
    reset,
    CLK,
    btns_in);
  output [0:0]btns_out;
  input reset;
  input CLK;
  input [0:0]btns_in;

  wire CLK;
  wire btn_out;
  wire btn_out_i_2__3_n_0;
  wire [0:0]btns_in;
  wire [0:0]btns_out;
  wire reset;
  wire [9:0]sreg;
  wire \sreg[4]_i_2__3_n_0 ;
  wire \sreg[5]_i_2__3_n_0 ;
  wire \sreg[6]_i_2__3_n_0 ;
  wire \sreg_reg_n_0_[3] ;
  wire \sreg_reg_n_0_[4] ;
  wire \sreg_reg_n_0_[5] ;
  wire \sreg_reg_n_0_[6] ;
  wire \sreg_reg_n_0_[7] ;
  wire \sreg_reg_n_0_[8] ;
  wire \sreg_reg_n_0_[9] ;

  LUT5 #(
    .INIT(32'h00000010)) 
    btn_out_i_1__3
       (.I0(\sreg_reg_n_0_[7] ),
        .I1(\sreg_reg_n_0_[8] ),
        .I2(btn_out_i_2__3_n_0),
        .I3(\sreg_reg_n_0_[6] ),
        .I4(\sreg_reg_n_0_[9] ),
        .O(btn_out));
  LUT6 #(
    .INIT(64'h0000000000004000)) 
    btn_out_i_2__3
       (.I0(\sreg_reg_n_0_[3] ),
        .I1(sreg[3]),
        .I2(sreg[2]),
        .I3(sreg[1]),
        .I4(\sreg_reg_n_0_[5] ),
        .I5(\sreg_reg_n_0_[4] ),
        .O(btn_out_i_2__3_n_0));
  FDRE btn_out_reg
       (.C(CLK),
        .CE(1'b1),
        .D(btn_out),
        .Q(btns_out),
        .R(reset));
  LUT6 #(
    .INIT(64'hFFFFFFFF00000010)) 
    \sreg[0]_i_1__3 
       (.I0(\sreg_reg_n_0_[9] ),
        .I1(\sreg_reg_n_0_[6] ),
        .I2(btn_out_i_2__3_n_0),
        .I3(\sreg_reg_n_0_[8] ),
        .I4(\sreg_reg_n_0_[7] ),
        .I5(btns_in),
        .O(sreg[0]));
  LUT6 #(
    .INIT(64'hFF00FF01FF00FE00)) 
    \sreg[4]_i_1__3 
       (.I0(\sreg_reg_n_0_[9] ),
        .I1(\sreg_reg_n_0_[7] ),
        .I2(\sreg_reg_n_0_[6] ),
        .I3(\sreg_reg_n_0_[3] ),
        .I4(\sreg_reg_n_0_[8] ),
        .I5(\sreg[4]_i_2__3_n_0 ),
        .O(sreg[4]));
  LUT6 #(
    .INIT(64'hFFFFFFFF10000000)) 
    \sreg[4]_i_2__3 
       (.I0(\sreg_reg_n_0_[4] ),
        .I1(\sreg_reg_n_0_[5] ),
        .I2(sreg[1]),
        .I3(sreg[2]),
        .I4(sreg[3]),
        .I5(\sreg_reg_n_0_[3] ),
        .O(\sreg[4]_i_2__3_n_0 ));
  LUT6 #(
    .INIT(64'hFFFFFFFF00010000)) 
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
        .S(reset));
  FDSE \sreg_reg[8] 
       (.C(CLK),
        .CE(1'b1),
        .D(sreg[8]),
        .Q(\sreg_reg_n_0_[8] ),
        .S(reset));
  FDSE \sreg_reg[9] 
       (.C(CLK),
        .CE(1'b1),
        .D(sreg[9]),
        .Q(\sreg_reg_n_0_[9] ),
        .S(reset));
endmodule
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
