DanielKirchner/bachelorarbeit/src/mandel-zybo.srcs/sources_1/bd/top/ip/top_buttons_0_2/top_buttons_0_2_sim_netlist.vhdl

-- Copyright 1986-2018 Xilinx, Inc. All Rights Reserved.
-- --------------------------------------------------------------------------------
-- Tool Version: Vivado v.2018.3 (lin64) Build 2405991 Thu Dec  6 23:36:41 MST 2018
-- Date        : Wed Jul  3 16:16:52 2019
-- Host        : daniel-pc running 64-bit unknown
-- Command     : write_vhdl -force -mode funcsim
--               /home/daniel/prg/uni/bachelor/src/mandel-zybo.srcs/sources_1/bd/top/ip/top_buttons_0_2/top_buttons_0_2_sim_netlist.vhdl
-- Design      : top_buttons_0_2
-- Purpose     : This VHDL netlist is a functional simulation representation of the design and should not be modified or
--               synthesized. This netlist cannot be used for SDF annotated simulation.
-- Device      : xc7z010clg400-1
-- --------------------------------------------------------------------------------
library IEEE;
use IEEE.STD_LOGIC_1164.ALL;
library UNISIM;
use UNISIM.VCOMPONENTS.ALL;
entity top_buttons_0_2_debounce is
  port (
    btns_out : out STD_LOGIC_VECTOR ( 0 to 0 );
    reset : in STD_LOGIC;
    CLK : in STD_LOGIC;
    btns_in : in STD_LOGIC_VECTOR ( 0 to 0 )
  );
  attribute ORIG_REF_NAME : string;
  attribute ORIG_REF_NAME of top_buttons_0_2_debounce : entity is "debounce";
end top_buttons_0_2_debounce;

architecture STRUCTURE of top_buttons_0_2_debounce is
  signal btn_out : STD_LOGIC;
  signal btn_out_i_2_n_0 : STD_LOGIC;
  signal sreg : STD_LOGIC_VECTOR ( 9 downto 0 );
  signal \sreg[4]_i_2_n_0\ : STD_LOGIC;
  signal \sreg[5]_i_2_n_0\ : STD_LOGIC;
  signal \sreg[6]_i_2_n_0\ : STD_LOGIC;
  signal sreg_0 : STD_LOGIC_VECTOR ( 9 downto 0 );
  attribute SOFT_HLUTNM : string;
  attribute SOFT_HLUTNM of \sreg[7]_i_1\ : label is "soft_lutpair0";
  attribute SOFT_HLUTNM of \sreg[8]_i_1\ : label is "soft_lutpair0";
begin
btn_out_i_1: unisim.vcomponents.LUT5
    generic map(
      INIT => X"00000010"
    )
        port map (
      I0 => sreg(7),
      I1 => sreg(8),
      I2 => btn_out_i_2_n_0,
      I3 => sreg(6),
      I4 => sreg(9),
      O => btn_out
    );
btn_out_i_2: unisim.vcomponents.LUT6
    generic map(
      INIT => X"0000000000004000"
    )
        port map (
      I0 => sreg(3),
      I1 => sreg(2),
      I2 => sreg(1),
      I3 => sreg(0),
      I4 => sreg(5),
      I5 => sreg(4),
      O => btn_out_i_2_n_0
    );
btn_out_reg: unisim.vcomponents.FDRE
     port map (
      C => CLK,
      CE => '1',
      D => btn_out,
      Q => btns_out(0),
      R => reset
    );
\sreg[0]_i_1\: unisim.vcomponents.LUT6
    generic map(
      INIT => X"FFFFFFFF00000010"
    )
        port map (
      I0 => sreg(9),
      I1 => sreg(6),
      I2 => btn_out_i_2_n_0,
      I3 => sreg(8),
      I4 => sreg(7),
      I5 => btns_in(0),
      O => sreg_0(0)
    );
\sreg[4]_i_1\: unisim.vcomponents.LUT6
    generic map(
      INIT => X"FF00FF01FF00FE00"
    )
        port map (
      I0 => sreg(9),
      I1 => sreg(7),
      I2 => sreg(6),
      I3 => sreg(3),
      I4 => sreg(8),
      I5 => \sreg[4]_i_2_n_0\,
      O => sreg_0(4)
    );
\sreg[4]_i_2\: unisim.vcomponents.LUT6
    generic map(
      INIT => X"FFFFFFFF10000000"
    )
        port map (
      I0 => sreg(4),
      I1 => sreg(5),
      I2 => sreg(0),
      I3 => sreg(1),
      I4 => sreg(2),
      I5 => sreg(3),
      O => \sreg[4]_i_2_n_0\
    );
\sreg[5]_i_1\: unisim.vcomponents.LUT6
    generic map(
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
