DanielKirchner/bachelorarbeit/(commit log)

2019-05-02 Skript zur Darstellung der Mandelbrotkonvergenz
2019-06-30 zahlenformat und zugehöriges skript
2019-07-14 luts und weiter
2019-07-28 neue kapitel, änderungen bei der farblut
